125jdavis/gauge/(threads)

Thread 11 (2025-06-10):

Add configuration file to improve code maintainability

125jdavis, 2025-06-10:
This change proposes adding a dedicated configuration file to improve code maintainability and make the gauge system more configurable.

## Proposed Configuration File

```cpp name=config.h
#ifndef GAUGE_CONFIG_H
#define GAUGE_CONFIG_H

// Pin Configurations
namespace PinConfig {
    // Analog Input Pins
    constexpr int VBATT_PIN = A0;       // Battery voltage sensing
    constexpr int FUEL_PIN = A1;        // Fuel level sensing
    constexpr int THERM_PIN = A2;       // Temperature sensor
    constexpr int BARO_PIN = A3;        // Barometric pressure sensor

    // Digital Output Pins
    constexpr int PWR_PIN = 2;          // Power control
    constexpr int MOTOR_RST = 3;        // Stepper motor reset
    constexpr int TACH_DATA_PIN = 4;    // LED tachometer data

    // Odometer Pins
    constexpr int ODO_PIN1 = 5;
    constexpr int ODO_PIN2 = 6;
    constexpr int ODO_PIN3 = 7;
    constexpr int ODO_PIN4 = 8;

    // CAN Bus Pins
    constexpr int CAN0_INT = 9;         // CAN interrupt pin
}

// Timing Constants (all in milliseconds)
namespace TimingConfig {
    constexpr unsigned long SPLASH_TIME = 3000;        // Splash screen duration
    constexpr unsigned long SENSOR_READ_RATE = 100;    // Sensor reading interval
    constexpr unsigned long CAN_SEND_RATE = 50;        // CAN message transmission interval
    constexpr unsigned long DISPLAY_UPDATE_RATE = 50;  // Display refresh rate
    constexpr unsigned long GPS_UPDATE_RATE = 200;     // GPS data fetch interval
    constexpr unsigned long TACH_UPDATE_RATE = 50;     // Tachometer update interval
    constexpr unsigned long ANGLE_UPDATE_RATE = 20;    // Gauge pointer update interval
    constexpr unsigned long DEBOUNCE_DELAY = 50;       // Switch debounce delay
}

// Display Configuration
namespace DisplayConfig {
    constexpr int SCREEN_W = 128;       // Display width in pixels
    constexpr int SCREEN_H = 32;        // Display height in pixels
    constexpr bool ROTATION = false;     // Display rotation (false = normal, true = 180°)
}

// Gauge Ranges and Limits
namespace GaugeConfig {
    // Tachometer
    constexpr int TACH_MIN = 0;         // Minimum RPM
    constexpr int TACH_MAX = 7000;      // Maximum RPM
    constexpr int NUM_LEDS = 16;        // Number of LEDs in tachometer
    constexpr int WARN_LEDS = 2;        // Number of warning LEDs
    constexpr int SHIFT_LEDS = 1;       // Number of shift indicator LEDs

    // Speedometer
    constexpr int SPEEDO_MAX = 12000;   // Maximum speed (x100 for precision)

    // Stepper Motor Configuration
    constexpr int M1_SWEEP = 120;       // Sweep angle for motor 1
    constexpr int M2_SWEEP = 120;       // Sweep angle for motor 2
    constexpr int M3_SWEEP = 240;       // Sweep angle for motor 3
    constexpr int M4_SWEEP = 120;       // Sweep angle for motor 4
}

// Sensor Filtering and Scaling
namespace SensorConfig {
    // Filter coefficients (0-64)
    constexpr int FILTER_VBATT = 32;    // Battery voltage filter strength
    constexpr int FILTER_FUEL = 32;     // Fuel level filter strength
    constexpr int FILTER_THERM = 32;    // Temperature filter strength
    constexpr int FILTER_BARO = 32;     // Barometric pressure filter strength

    // Scaling factors
    constexpr float VBATT_SCALER = 0.0208;  // Battery voltage scaling factor
    constexpr float FUEL_CAPACITY = 16.0;    // Fuel tank capacity in gallons
}

// CAN Bus Configuration
namespace CANConfig {
    constexpr long CAN_SPEED = CAN_500KBPS;
    constexpr int CAN_CS = 10;          // CS pin for CAN controller

    // CAN Message IDs
    constexpr uint32_t ID_ENGINE_DATA = 0x360;    // Engine data message ID
    constexpr uint32_t ID_SENSOR_DATA = 0x361;    // Sensor data message ID
    constexpr uint32_t ID_STATUS = 0x362;         // Status message ID
}

// EEPROM Storage Addresses
namespace StorageConfig {
    constexpr int DISP_ARRAY1_ADDR = 0;          // Display 1 configuration
    constexpr int DISP_ARRAY2_ADDR = 10;         // Display 2 configuration
    constexpr int CLOCK_OFFSET_ADDR = 20;        // Clock offset
    constexpr int ODO_ADDR = 30;                 // Odometer value
    constexpr int ODO_TRIP_ADDR = 40;            // Trip odometer value
    constexpr int FUEL_SENSOR_RAW_ADDR = 50;     // Raw fuel sensor value
    constexpr int UNITS_ADDR = 60;               // Units configuration (metric/imperial)
}

#endif // GAUGE_CONFIG_H
```

## Implementation Steps

1. Create the new `config.h` file in the project.
2. Update the main sketch to include and use the configuration file:
   ```cpp
   #include "config.h"
   ```
3. Replace all hardcoded values in the main sketch with references to the configuration constants.
4. Update any affected functions to use the new configuration values.

## Benefits

1. **Improved Maintainability**
   - All configuration values are in one place
   - Easy to find and modify settings
   - Better documentation of what each value represents

2. **Better Organization**
   - Related settings are grouped together
   - Clear separation of different types of configuration
   - Namespaces prevent naming conflicts

3. **Easier Customization**
   - Simple to modify values for different vehicle applications
   - Clear documentation of valid ranges and units
   - Configuration can be changed without modifying main code

4. **Reduced Risk of Errors**
   - Use of constexpr ensures compile-time checking
   - Prevents accidental modification of constants
   - Consistent naming conventions

## Testing Plan

1. Compare all values in the configuration file against current implementation
2. Test the system with the new configuration values
3. Verify that all functionality remains the same
4. Test boundary conditions with different configuration values

## Future Considerations

- Consider adding configuration validation functions
- Could expand to include different preset configurations for different vehicles
- Might want to add debug configuration options
