125jdavis/gauge/documentation/Schematic_gauge-module-v4_2025-11-08.pdf

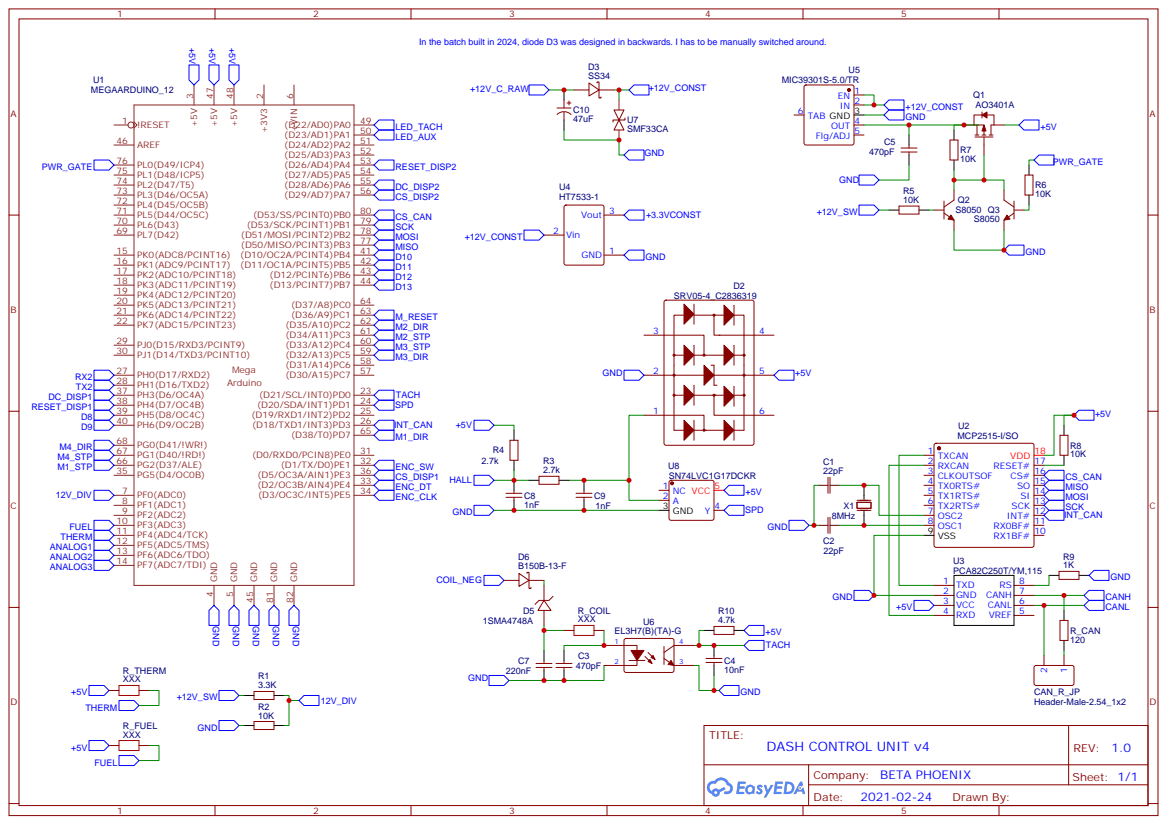
[picture p1: page 1]

In the batch built in 2024, diode D3 was designed in backwards. I has to be manually switched around.

11 11 12 12 13 13 14 14 15 15 16 16

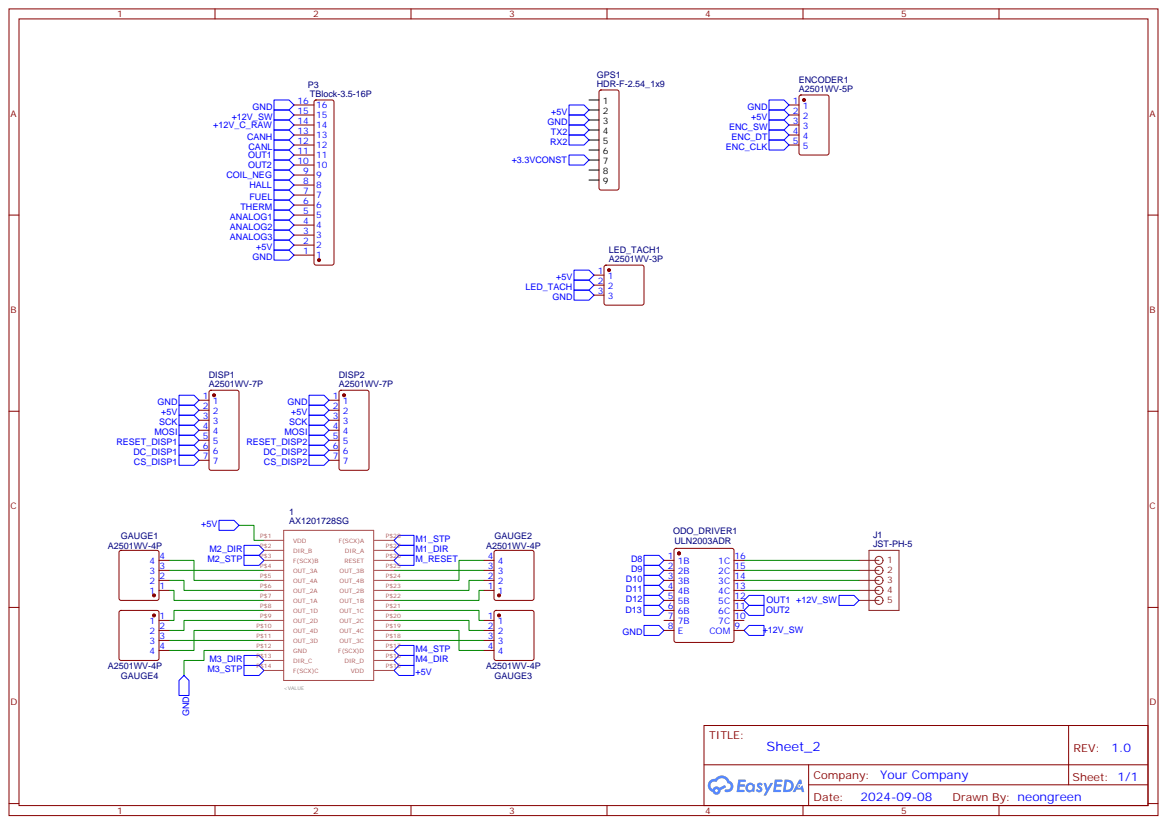
[picture p2: page 2]
