125jdavis/gauge/gauge_V4/gauge_V4.ino

/*
 * ========================================
 * GAUGE CONTROL MODULE
 * ========================================
 * 
 * Arduino-based instrument panel controller for vintage vehicles
 * 
 * Author: Jesse Davis
 * Date: 8/24/2024
 * 
 * OVERVIEW:
 * This system receives inputs from GPS, analog sensors, and CAN bus, then outputs to:
 * - 4x stepper motors for gauge pointers (speedometer, fuel, coolant temp, etc.)
 * - LED warning lights and LED tachometer strip
 * - 2x OLED displays for various vehicle data
 * - CAN bus messages to other microcontrollers
 * 
 * The design is modular to simplify retrofitting vintage instrument panels with modern internals.
 * 
 * HARDWARE:
 * - Arduino Mega 2560 (or compatible)
 * - MCP2515 CAN bus controller
 * - Adafruit GPS module
 * - 2x SSD1306 OLED displays (128x32 pixels)
 * - 4x SwitecX12 stepper motors for gauge needles
 * - WS2812 LED strip for tachometer
 * - Rotary encoder for menu navigation
 * - Various analog sensors (fuel level, thermistor, barometric pressure, battery voltage)
 * 
 * COMMUNICATION PROTOCOLS:
 * - CAN bus at 500kbps (Haltech ECU protocol)
 * - GPS at 9600 baud, NMEA RMC messages at 5Hz
 * - SPI for displays and CAN controller
 * 
 * ========================================
 */

///// LIBRARIES /////
// Display libraries
#include <Adafruit_SSD1306.h>
#include <Adafruit_GFX.h>

// Communication libraries
#include <SPI.h>
#include <mcp_can.h>

// Input libraries
#include <Rotary.h>

// Storage library
#include <EEPROM.h>

// LED library
#include <FastLED.h>

// GPS library
#include <Adafruit_GPS.h>

// Stepper motor libraries
#include <SwitecX25.h>
#include <SwitecX12.h>

///// PROJECT MODULES /////
#include "config_hardware.h"
#include "config_calibration.h"
#include "globals.h"
#include "gps.h"
#include "can.h"
#include "sensors.h"
#include "display.h"
#include "outputs.h"
#include "menu.h"
#include "utilities.h"
#include "image_data.h"
#include "serial_config.h"
#include "splash.h"



/*
 * ========================================
 * TIMER-BASED MOTOR UPDATE ISR
 * ========================================
 * 
 * This ISR is called at MOTOR_UPDATE_FREQ_HZ (default 10 kHz) by Timer3
 * to provide deterministic, smooth motor stepping independent of main loop timing.
 * 
 * Design rationale:
 * - Main loop has variable execution time due to display updates, CAN, GPS parsing
 * - update() calls from main loop result in irregular step timing → jerky motion
 * - Timer-driven updates provide consistent intervals → smooth motion
 * - 10 kHz frequency ensures steps at max motor speed don't accumulate delays
 * 
 * ISR performance:
 * - Executes in ~10-20 µs with 5 motors (measured on Mega 2560)
 * - At 10 kHz: ~10-20% CPU overhead (10-20 µs per 100 µs period)
 * - Kept minimal: only calls update() on each motor, no complex logic
 * 
 * Motors updated:
 * - motor1, motor2, motor3, motor4 (SwitecX12 gauge motors)
 * - motorS (SwitecX12 speedometer motor)
 * - updateOdometerMotor() (mechanical odometer, custom non-blocking implementation)
 */
ISR(TIMER3_COMPA_vect) {
  // Update all gauge motors (SwitecX12)
  // These motors have internal acceleration/deceleration logic
  // and track their own timing via micros()
  motor1.update();
  motor2.update();
  motor3.update();
  motor4.update();
  motorS.update();
  
  // Update mechanical odometer motor (custom non-blocking implementation)
  updateOdometerMotor();
}

/**
 * initMotorUpdateTimer - Initialize Timer3 for motor update ISR
 * 
 * Configures Timer3 to generate periodic interrupts at MOTOR_UPDATE_FREQ_HZ
 * for deterministic motor stepping.
 * 
 * Timer3 configuration:
 * - Mode: CTC (Clear Timer on Compare Match) - resets counter at OCR3A
 * - Prescaler: 8 (provides good resolution for target frequency range)
 * - Compare value: Calculated from F_CPU and target frequency
 * 
 * Calculation:
 * - Timer frequency = F_CPU / prescaler = 16 MHz / 8 = 2 MHz
 * - Timer ticks per interrupt = timer_freq / target_freq
 * - For 10 kHz target: 2,000,000 / 10,000 = 200 ticks
 * - OCR3A = 200 - 1 = 199 (compare triggers at 199, giving 200 ticks per cycle)
 * 
 * CPU overhead:
 * - ISR executes ~10-20 µs
 * - At 10 kHz: 100-200 µs per millisecond = 10-20% worst case
 * - Typical is lower due to early exits in update()
 */
void initMotorUpdateTimer() {
  // Disable interrupts while configuring timer
  cli();
  
  // Timer3 configuration for CTC mode
  TCCR3A = 0;  // Clear control register A
  TCCR3B = 0;  // Clear control register B
  TCNT3 = 0;   // Initialize counter to 0
  
  // Calculate compare match value
  // Formula: OCR3A = (F_CPU / (prescaler * target_frequency)) - 1
  // With prescaler = 8:
  //   Timer frequency = 16 MHz / 8 = 2 MHz
  //   For 10 kHz: OCR3A = (2,000,000 / 10,000) - 1 = 199
  const uint16_t prescaler = 8;
  const uint32_t timer_freq = F_CPU / prescaler;  // 2 MHz with prescaler=8
  const uint16_t compare_value = (timer_freq / MOTOR_UPDATE_FREQ_HZ) - 1;
  
  OCR3A = compare_value;  // Set compare match register
  
  // Configure Timer3 for CTC mode with prescaler = 8
  // CTC mode: WGM32:0 = 0b0100 (CTC mode, TOP = OCR3A)
  // CS32:0 = 0b010 (prescaler = 8)
  TCCR3B |= (1 << WGM32) | (1 << CS31);
  
  // Enable Timer3 Compare A interrupt
  TIMSK3 |= (1 << OCIE3A);
  
  // Re-enable interrupts
  sei();
  
  // Debug output
  Serial.print(F("Motor update timer initialized: "));
  Serial.print(MOTOR_UPDATE_FREQ_HZ);
  Serial.print(F(" Hz (OCR3A="));
  Serial.print(compare_value);
  Serial.println(F(")"));
}

/*
 * ========================================
 * SETUP FUNCTION
 * ========================================
 */
void setup() {

  // Initialize serial communication for debugging
  Serial.begin(115200);

  // Keep power enabled after ignition switch turns off
  pinMode(PWR_PIN, OUTPUT);
  digitalWrite(PWR_PIN, HIGH);

  // ===== GPS INITIALIZATION =====
  GPS.begin(9600);
  GPS.sendCommand(PMTK_SET_NMEA_OUTPUT_RMCONLY);
  GPS.sendCommand(PMTK_SET_NMEA_UPDATE_5HZ);
  GPS.sendCommand(PMTK_API_SET_FIX_CTL_5HZ);
  useInterrupt(true);
 
  // ===== HALL SENSOR INITIALIZATION =====
  pinMode(HALL_PIN, INPUT_PULLUP);
  attachInterrupt(digitalPinToInterrupt(HALL_PIN), hallSpeedISR, FALLING);

  // ===== ENGINE RPM SENSOR INITIALIZATION =====
  pinMode(IGNITION_PULSE_PIN, INPUT_PULLUP);
  attachInterrupt(digitalPinToInterrupt(IGNITION_PULSE_PIN), ignitionPulseISR, FALLING);

  // ===== DISPLAY INITIALIZATION =====
  // Initialize displays (SPI clock speed set by library default)
  // begin(vccstate, i2caddr, reset, periphBegin)
  display1.begin(SSD1306_SWITCHCAPVCC, 0, true, true);
  display2.begin(SSD1306_SWITCHCAPVCC, 0, true, true);
  dispFalconScript(&display1);
  disp302CID(&display2);
  
  // ===== STEPPER MOTOR INITIALIZATION =====
  pinMode(MOTOR_RST, OUTPUT);
  digitalWrite(MOTOR_RST, HIGH);
  motorSweepSynchronous();
  
  // ===== ODOMETER MOTOR SETUP =====
  pinMode(ODO_PIN1, OUTPUT);
  pinMode(ODO_PIN2, OUTPUT);
  pinMode(ODO_PIN3, OUTPUT);
  pinMode(ODO_PIN4, OUTPUT);

  // ===== LED TACHOMETER INITIALIZATION =====
  if (!loadTachSettings()) {
    Serial.println(F("Warning: invalid tach settings in EEPROM; using defaults"));
  }
  if (NUM_LEDS > MAX_LEDS) {
    NUM_LEDS = MAX_LEDS;
    Serial.println("Warning: NUM_LEDS exceeds MAX_LEDS, clamped to maximum");
  }
  FastLED.addLeds<WS2812, TACH_DATA_PIN, GRB>(leds, NUM_LEDS);

  // ===== ROTARY ENCODER SETUP =====
  pinMode(SWITCH, INPUT_PULLUP);
  attachInterrupt(digitalPinToInterrupt(2), rotate, CHANGE);
  attachInterrupt(digitalPinToInterrupt(3), rotate, CHANGE);
  
  // ===== LOAD SAVED SETTINGS FROM EEPROM =====
  for (int i = 0; i < sizeof(dispArray1); i++) {
    dispArray1[i] = EEPROM.read(dispArray1Address + i);
  }
  dispArray2[0] = EEPROM.read(dispArray2Address);
  loadScreenLists();  // Also forces the restored screens to be members of their lists
  clockOffset = EEPROM.read(clockOffsetAddress); 
  EEPROM.get(odoAddress, odo);
  EEPROM.get(odoTripAddress, odoTrip);
  EEPROM.get(fuelSensorRawAddress, fuelSensorRaw);
  EEPROM.get(unitsAddress, units);

  Serial.print("clockOffset: ");
  Serial.println(clockOffset);
  
  // ===== CAN BUS INITIALIZATION =====
  if(CAN0.begin(MCP_ANY, CAN_500KBPS, MCP_8MHZ) == CAN_OK) 
    Serial.println("MCP2515 Initialized Successfully!");
  else 
    Serial.println("Error Initializing MCP2515...");
  
  // Configure hardware filters to reduce MCU load
  configureCANFilters();
  Serial.print("CAN filters configured for protocol: ");
  Serial.println(CAN_PROTOCOL);
  
  pinMode(CAN0_INT, INPUT);
  CAN0.setMode(MCP_NORMAL);

  // ===== MOTOR UPDATE TIMER INITIALIZATION =====
  // Initialize Timer3 for deterministic motor stepping at MOTOR_UPDATE_FREQ_HZ
  // This must be done after motor initialization but before main loop starts
  initMotorUpdateTimer();

  // ===== SPLASH SCREEN DELAY =====
  while (millis() < SPLASH_TIME){
    // Wait for splash screen timer to expire
  }

}

/*
 * ========================================
 * MAIN LOOP FUNCTION
 * ========================================
 */
void loop() {

  // ===== ANALOG SENSOR READING =====
  if (millis() - timerSensorRead > SENSOR_READ_RATE) {
    static int32_t battFilterState = 0;
    static int32_t fuelFilterState = 0;
    vBattRaw = readSensor(VBATT_PIN, vBattRaw, FILTER_VBATT, battFilterState);
    vBatt = (float)vBattRaw * VBATT_SCALER;
    
    fuelSensorRaw = readSensor(FUEL_PIN, fuelSensorRaw, FILTER_FUEL, fuelFilterState);
    
    thermSensor = readThermSensor(THERM_PIN, thermSensor, FILTER_THERM);
    therm = curveLookup((uint16_t)(thermSensor * 1000.0f), thermTable_x, thermTable_l, thermTable_length);
    thermCAN = (int)(therm*10);
    
    sensor_av1 = readMappedSensor(PIN_AV1, sensor_av1, FILTER_AV1, 0, AV1_TYPE);
    sensor_av2 = readMappedSensor(PIN_AV2, sensor_av2, FILTER_AV2, 1, AV2_TYPE);
    sensor_av3 = readMappedSensor(PIN_AV3, sensor_av3, FILTER_AV3, 2, AV3_TYPE);

        swRead();
    
    timerSensorRead = millis();
  }

  // ===== HALL SENSOR READING ======
  if (millis() - timerHallUpdate > HALL_UPDATE_RATE) {
    hallSpeedUpdate();
    timerHallUpdate = millis();
  }

  // ===== ENGINE RPM SENSOR READING =====
  if (millis() - timerEngineRPMUpdate > ENGINE_RPM_UPDATE_RATE) {
    engineRPMUpdate();
    timerEngineRPMUpdate = millis();
  }

  // ===== CAN BUS RECEPTION =====
  // Drain all pending frames: the MCP2515 only has 2 RX buffers, so reading one frame
  // per loop pass drops frames (e.g. 0x370 speed) when the loop is slow
  for (byte canReads = 0; canReads < 16 && !digitalRead(CAN0_INT); canReads++) {
    receiveCAN();
    parseCAN(rxId, 0);
  }

  // ===== OBDII POLLING =====
  // Poll ECU for parameters when using OBDII protocol
  if (CAN_PROTOCOL == CAN_PROTOCOL_OBDII) {
    pollOBDII();
  }

  // ===== GPS DATA PROCESSING =====
  if (millis() - timerCheckGPS > CHECK_GPS_RATE) {
    fetchGPSdata();
    timerCheckGPS = millis();
  }

  // ===== SERIAL COMMAND PROCESSING =====
  // Parse serial input for manual signal injection (spd, rpm, odo motor commands)
  processSerialCommands();

  // ===== SIGNAL SELECTION UPDATE =====
  // Process sensor readings and synthetic signal generators
  // Runs at 100Hz for responsive synthetic signals
  if (millis() - timerSigSelectUpdate > SIG_SELECT_UPDATE_RATE) {
    sigSelect();
    timerSigSelectUpdate = millis();
  }

  // ===== MOTOR ANGLE UPDATE =====
  // Set target positions for motors based on sensor readings
  // The actual stepping is handled by Timer3 ISR at MOTOR_UPDATE_FREQ_HZ
  // This decouples position updates (slow, ~50 Hz) from stepping (fast, 10 kHz)
  // CRITICAL: This block is positioned BEFORE display updates to ensure consistent timing.
  // Display updates are blocking operations (~10-20ms) that would otherwise delay
  // angle updates, causing visible jitter/ticks in motor motion.
  if (millis() - timerAngleUpdate > ANGLE_UPDATE_RATE) {
    //Serial.println(millis() - timerAngleUpdate);
    // Motors 1-4 use smoothing: update targets at ANGLE_UPDATE_RATE, interpolation happens below
    updateMotors1to4Target(motorFunctionAngle(M1_FUNCTION, M1_SWEEP, M1_MIN, M1_MAX),
                           motorFunctionAngle(M2_FUNCTION, M2_SWEEP, M2_MIN, M2_MAX),
                           motorFunctionAngle(M3_FUNCTION, M3_SWEEP, M3_MIN, M3_MAX),
                           motorFunctionAngle(M4_FUNCTION, M4_SWEEP, M4_MIN, M4_MAX));
    // Motor S uses smoothing: update target at ANGLE_UPDATE_RATE, interpolation happens below
    updateMotorSTarget(MS_SWEEP);
    timerAngleUpdate = millis();
  }
  
  // ===== MOTOR S POSITION SMOOTHING =====
  // Continuously interpolate motorS position between target updates for smooth motion
  // Called every loop iteration (typically >1kHz) to provide frequent position updates
  // that the Timer3 ISR can act upon. This creates smooth needle motion instead of
  // the jerky "move-stop-wait" behavior that occurs without interpolation.
  updateMotorSSmoothing();

  // ===== MOTORS 1-4 POSITION SMOOTHING =====
  // Same adaptive linear interpolation as motorS, applied to the fuel/temp gauge motors.
  updateMotors1to4Smoothing();

  // ===== MOTOR STEP EXECUTION =====
  // Motor updates (stepping) are now handled by Timer3 ISR for deterministic timing
  // The ISR calls:
  //   - motor1/2/3/4/S.update() for gauge motors
  //   - updateOdometerMotor() for mechanical odometer
  // 
  // This provides smooth motion independent of main loop timing variations
  // caused by display updates, GPS parsing, CAN processing, etc.
  //
  // Note: Do not call update() here - would conflict with ISR and cause race conditions

  // ===== LED TACHOMETER UPDATE =====
  if (millis() - timerTachUpdate > TACH_UPDATE_RATE) {
    ledShiftLight(RPM);
    timerTachUpdate = millis();
  }

  // ===== DISPLAY UPDATE =====
  // Positioned AFTER motor angle updates to prevent blocking OLED operations
  // from delaying time-critical motor position updates
  // Each display uses independent timing with variable refresh rates based on content
  
  // Check for user input requiring immediate display update
  bool needsImmediateUpdate = (button == 1) || encoderMoved;
  
  // Display 1 update - Variable refresh rate based on content type
  // Update immediately on user input, or at scheduled interval
  unsigned int disp1Interval = getDisplayUpdateInterval(dispArray1[0], 1);
  if (needsImmediateUpdate || (millis() - timerDisp1Update > disp1Interval)) {
    // Force a full redraw when the user scrolled to a new screen, so the display
    // function always sees modeChanged=true and clears leftover content.
    if (encoderMoved) {
      dispArray1_prev[0] = 255;
    }
    dispMenu();
    timerDisp1Update = millis();
    encoderMoved = false;  // Clear flag after update
  }
  
  // Display 2 update - Variable refresh rate based on content type
  // Update immediately when selection changes (e.g., scrolling through Display 2 options in Settings)
  // or when button is pressed (entering Display 2 submenu), or at scheduled interval for data refresh
  bool disp2SelectionChanged = (dispArray2[0] != dispArray2_prev);
  bool needsDisp2Update = disp2SelectionChanged || needsImmediateUpdate;
  unsigned int disp2Interval = getDisplayUpdateInterval(dispArray2[0], 2);
  if (needsDisp2Update || (millis() - timerDisp2Update > disp2Interval)) {
    // Force a full redraw when the Display 2 selection changed, so the display
    // function always sees modeChanged=true and clears leftover content.
    if (disp2SelectionChanged) {
      dispArray2_prev = 255;
    }
    disp2();
    timerDisp2Update = millis();
  }

  // ===== FAULT DEBOUNCE + FLASH =====
  // Raw fault conditions are debounced: each must persist continuously for
  // FAULT_DEBOUNCE_MS before the warning (OLED invert + LED) activates.
  // Clearing the condition immediately resets the debounce timer.
  //
  // Fault conditions:
  //   - Oil pressure below OIL_PRS_WARN_THRESHOLD (kPa gauge) while engine is running
  //   - Coolant temperature above COOLANT_TEMP_WARN_THRESHOLD (°C) while engine is running
  //   - Battery voltage below BATT_VOLT_WARN_THRESHOLD (V) (engine-state independent)
  //   - Fuel level below FUEL_LVL_WARN_THRESHOLD_PCT (%) when fuel source is active
  {
    bool engineRunning = (RPM >= ENGINE_RUNNING_RPM_MIN);
    bool oilPrsRaw  = engineRunning && (oilPrs < OIL_PRS_WARN_THRESHOLD);
    bool coolantRaw = engineRunning && (coolantTemp > COOLANT_TEMP_WARN_THRESHOLD);
    bool battRaw    = (vBatt > BATT_VOLT_MIN_VALID) && (vBatt < BATT_VOLT_WARN_THRESHOLD);
    bool fuelRaw    = (FUEL_LVL_SOURCE != 0) && (fuelLvlCAN < FUEL_LVL_WARN_THRESHOLD_PCT);

    // Debounce: reset timer while condition is false; activate after FAULT_DEBOUNCE_MS
    unsigned long now = millis();
    if (!oilPrsRaw)  { timerOilFaultDebounce     = now; oilFaultActive     = false; }
    else if (now - timerOilFaultDebounce     >= FAULT_DEBOUNCE_MS) oilFaultActive     = true;
    if (!coolantRaw) { timerCoolantFaultDebounce  = now; coolantFaultActive = false; }
    else if (now - timerCoolantFaultDebounce >= FAULT_DEBOUNCE_MS) coolantFaultActive = true;
    if (!battRaw)    { timerBattFaultDebounce     = now; battFaultActive    = false; }
    else if (now - timerBattFaultDebounce    >= FAULT_DEBOUNCE_MS) battFaultActive    = true;
    if (!fuelRaw)    { timerFuelFaultDebounce     = now; fuelFaultActive    = false; }
    else if (now - timerFuelFaultDebounce    >= FAULT_DEBOUNCE_MS) fuelFaultActive    = true;

    // Determine which displays are showing a faulted reading
    bool disp1Fault = (oilFaultActive     && (dispArray1[0] == 1)) ||
                      (coolantFaultActive && (dispArray1[0] == 2)) ||
                      (fuelFaultActive    && (dispArray1[0] == 3)) ||
                      (battFaultActive    && (dispArray1[0] == 4));
    bool disp2Fault = (oilFaultActive     && (dispArray2[0] == 1)) ||
                      (coolantFaultActive && (dispArray2[0] == 2)) ||
                      (fuelFaultActive    && (dispArray2[0] == 3)) ||
                      (battFaultActive    && (dispArray2[0] == 4));

    // Toggle flash state every FAULT_FLASH_INTERVAL_MS
    if (millis() - timerFaultFlash >= FAULT_FLASH_INTERVAL_MS) {
      faultFlashState = !faultFlashState;
      timerFaultFlash = millis();
    }

    // Apply hardware inversion only when the desired state changes, to minimize SPI traffic
    static bool disp1InvertPrev = false;
    static bool disp2InvertPrev = false;
    bool disp1Invert = disp1Fault && faultFlashState;
    bool disp2Invert = disp2Fault && faultFlashState;
    if (disp1Invert != disp1InvertPrev) {
      display1.invertDisplay(disp1Invert);
      disp1InvertPrev = disp1Invert;
    }
    if (disp2Invert != disp2InvertPrev) {
      display2.invertDisplay(disp2Invert);
      disp2InvertPrev = disp2Invert;
    }
  }

  // ===== CAN BUS TRANSMISSION =====
  if (millis() - timerCANsend > CAN_SEND_RATE) {  
    //sendCAN_BE(0x200, 0, spdCAN, 0, 0);
    timerCANsend = millis();
  }


  //===== SHUTDOWN DETECTION =====
  //Check if ignition voltage has dropped (key turned off)
  //Shutdown when battery voltage < 1V AND system has been running for at least 3 seconds
  if (vBatt < 1 && millis() > SPLASH_TIME + 3000) {
    shutdown();  // Save settings, zero gauges, display shutdown screen, cut power
  }


}
