125jdavis/gauge/gauge_V4/sensors.cpp

/*
 * ========================================
 * SENSOR READING FUNCTIONS IMPLEMENTATION
 * ========================================
 */

#include "sensors.h"
#include "globals.h"
#include "outputs.h"
#include "utilities.h"
#include "ema_filter.h"
#include <util/atomic.h>

static volatile int32_t rpmFilterState = 0;

// ===== VR-SAFE COMBINED FILTER STATE =====
// State machine for startup filtering (VR-safe, Hall-compatible)
enum SpeedSensorState {
    STANDSTILL,  // No recent pulses, speed = 0
    STARTING,    // Pulses arriving but not yet coherent
    MOVING       // Normal operation, speed output active
};

// Ring buffer for median filter on pulse intervals
#define INTERVAL_BUFFER_SIZE 5
static unsigned long intervalBuffer[INTERVAL_BUFFER_SIZE] = {0};
static uint8_t intervalBufferIndex = 0;
static uint8_t intervalBufferCount = 0;

// State machine variables
static SpeedSensorState sensorState = STANDSTILL;
static unsigned long lastFilteredInterval = 0;
static unsigned long lastPulseArrivalTime = 0;  // Track when last pulse was added to buffer

// Previous speed for acceleration limiting
static unsigned int spdHallPrev = 0;
static unsigned long lastSpeedUpdateTime = 0;

// CAN odometer update tracking
static unsigned long lastCANOdometerUpdateTime = 0;

// Synthetic speed odometer update tracking
static unsigned long lastSyntheticOdometerUpdateTime = 0;

// Serial speed odometer update tracking
static unsigned long lastSerialOdometerUpdateTime = 0;

// VR-Safe filter constants
#define LOW_SPEED_THRESHOLD_FOR_VR_REJECTION 1000  // 10 km/h in units of km/h*100
#define MAX_ACCELERATION_UNITS 3530UL  // 1g acceleration ≈ 35.3 km/h/s ≈ 3530 (km/h*100)/s

static unsigned long filterIntegerSensor(unsigned long newVal, int oldVal, int filt, int32_t &state)
{
    if (state / 128 != oldVal) state = (int32_t)oldVal * 128;
    state = ema7Step((int32_t)newVal * 128, state, filt);
    return state / 128;
}

/**
 * readSensor - Generic analog sensor reader with filtering
 */
unsigned long readSensor(int inputPin, int oldVal, int filt, int32_t &state)
{
    int raw = analogRead (inputPin);  // Read ADC: 0-1023 for 0-5V input
    unsigned long newVal = map( raw, 0, 1023, 0, 500);  // Map to 0-500 (0.00-5.00V in 0.01V steps)
    return filterIntegerSensor(newVal, oldVal, filt, state);
}

/**
 * read30PSIAsensor - Read 30 PSI absolute pressure sensor
 */
unsigned long read30PSIAsensor(int inputPin, int oldVal, int filt, int32_t &state)
{
    int raw = constrain(analogRead(inputPin), 102, 921);  // Read ADC: 0-1023
    unsigned long newVal = map( raw, 102, 921, 0, 2068);  // Map 0.5-4.5V to 0-30 PSIA (0-206.8 kPa)
    return filterIntegerSensor(newVal, oldVal, filt, state);
}

/**
 * read3barMapSensor - Read a 3 bar absolute MAP sensor
 */
unsigned long read3barMapSensor(int inputPin, int oldVal, int filt, int32_t &state)
{
    int raw = constrain(analogRead(inputPin), 102, 921);
    unsigned long newVal = map(raw, 102, 921, 0, 3000);
    return filterIntegerSensor(newVal, oldVal, filt, state);
}

/**
 * read100PSIGsensor - Read a 0-100 PSIG pressure sensor
 */
unsigned long read100PSIGsensor(int inputPin, int oldVal, int filt, int32_t &state)
{
    int raw = constrain(analogRead(inputPin), 102, 921);
    unsigned long newVal = map(raw, 102, 921, 0, 6895);
    return filterIntegerSensor(newVal, oldVal, filt, state);
}

/**
 * readMappedSensor - Linearly map an AV input using its ADC/physical calibration points
 *
 * Result is in the calibration's physical units (absolute kPa*10 or Lambda*1000).
 * AV_TYPE_NONE inputs return raw voltage (0.01V units).
 */
float readMappedSensor(int inputPin, float oldVal, int filt, uint8_t avIndex, uint8_t type)
{
    if (type == AV_TYPE_NONE) {
        long newVal = map(analogRead(inputPin), 0, 1023, 0, 500);
        return ema7Step(newVal * 128, (int32_t)(oldVal * 128), filt) / 128.0f;
    }
    long adcLo = AV_ADC_LO[avIndex];
    long adcHi = AV_ADC_HI[avIndex];
    if (adcLo == adcHi) return AV_PHYS_LO[avIndex];
    long raw = constrain((long)analogRead(inputPin), min(adcLo, adcHi), max(adcLo, adcHi));
    long newVal = map(raw, adcLo, adcHi, AV_PHYS_LO[avIndex], AV_PHYS_HI[avIndex]);
    return ema7Step(newVal * 128, (int32_t)(oldVal * 128), filt) / 128.0f;
}

/**
 * avGaugeKpa / avAbsoluteKpa - Convert an AV reading (absolute kPa*10) to kPa gauge / absolute
 */
static float avGaugeKpa(float raw)
{
    return raw / 10.0 - 101.3;
}

static float avAbsoluteKpa(float raw)
{
    return raw / 10.0;
}
/**
 * readThermSensor - Read GM-style thermistor temperature sensor
 */
float readThermSensor(int inputPin, float oldVal, int filt)
{
    int raw = analogRead (inputPin);  // Read ADC: 0-1023
    int32_t newMillivolts = map(raw, 0, 1023, 0, 500) * 10L;
    int32_t state = (int32_t)(oldVal * 128000.0f + 0.5f);
    return ema7Step(newMillivolts * 128, state, filt) / 128000.0f;
}

/**
 * getMedianInterval - Calculate median of interval buffer
 * VR-Safe: Median filter rejects outlier pulses from VR sensor noise
 * Hall-Compatible: Works identically with clean Hall sensor pulses
 * 
 * @return Median interval from buffer, or 0 if buffer empty
 */
static unsigned long getMedianInterval() {
    if (intervalBufferCount == 0) return 0;
    
    // Create a copy for sorting (small N, simple bubble sort is fine)
    unsigned long sorted[INTERVAL_BUFFER_SIZE];
    uint8_t n = intervalBufferCount;
    
    for (uint8_t i = 0; i < n; i++) {
        sorted[i] = intervalBuffer[i];
    }
    
    // Bubble sort (safe against underflow)
    for (uint8_t i = 0; i < n - 1 && i < n; i++) {
        for (uint8_t j = 0; j + i + 1 < n; j++) {
            if (sorted[j] > sorted[j + 1]) {
                unsigned long temp = sorted[j];
                sorted[j] = sorted[j + 1];
                sorted[j + 1] = temp;
            }
        }
    }
    
    // Return median
    if (n % 2 == 1) {
        return sorted[n / 2];
    } else {
        return (sorted[n / 2 - 1] + sorted[n / 2]) / 2;
    }
}

/**
 * checkIntervalCoherence - Check if intervals in buffer are coherent
 * VR-Safe: Ensures startup intervals are stable before outputting speed
 * 
 * @return true if max/min ratio < 1.5, false otherwise
 */
static bool checkIntervalCoherence() {
    if (intervalBufferCount < INTERVAL_BUFFER_SIZE) return false;
    
    unsigned long minInterval = intervalBuffer[0];
    unsigned long maxInterval = intervalBuffer[0];
    
    for (uint8_t i = 1; i < intervalBufferCount; i++) {
        if (intervalBuffer[i] < minInterval) minInterval = intervalBuffer[i];
        if (intervalBuffer[i] > maxInterval) maxInterval = intervalBuffer[i];
    }
    
    // Avoid division by zero
    if (minInterval == 0) return false;
    
    // Check if max/min < 1.5 (coherence threshold)
    // Use integer math: maxInterval < 1.5 * minInterval
    // Equivalent to: maxInterval * 2 < minInterval * 3
    return (maxInterval * 2) < (minInterval * 3);
}

/**
 * hallSpeedISR - Hall effect speed sensor interrupt handler
 * 
 * ISR Design: Lightweight and deterministic
 * - Captures pulse timestamp using micros()
 * - Performs basic sanity checks on pulse interval
 * - Enqueues interval into ring buffer for median filtering
 * - All heavy processing deferred to hallSpeedUpdate() in main loop
 * 
 * Performance: ~8-15 µs execution time (mostly conditional checks)
 * 
 * VR-Safe Combined Filter Implementation:
 * - Timestamps pulses and enqueues intervals into ring buffer
 * - Rejects intervals that fail basic sanity checks
 * - VR-Safe: Rejects edge misfires at low speed (interval < 0.4× previous)
 * - Hall-Compatible: All checks pass transparently for clean Hall signals
 * 
 * Heavy processing deferred to main loop:
 * - Median filtering
 * - State machine transitions
 * - Speed calculation
 * - Acceleration limiting
 */
void hallSpeedISR() {
    unsigned long currentTime = micros();
    unsigned long pulseInterval = currentTime - hallLastTime;
    
    // Basic interval sanity checks
    // Minimum: 100 μs (filters electrical noise, allows up to ~500 km/h)
    // Maximum: MAX_VALID_PULSE_INTERVAL (filters stale intervals from standstill)
    if (pulseInterval <= 100 || pulseInterval >= MAX_VALID_PULSE_INTERVAL) {
        // Very long interval = standstill detected
        if (pulseInterval >= MAX_VALID_PULSE_INTERVAL) {
            hallLastTime = currentTime;
            sensorState = STANDSTILL;
            intervalBufferCount = 0;
            intervalBufferIndex = 0;
        }
        return;
    }
    
    // VR-Safe: Low-speed robustness check
    // Reject intervals < 0.4× previous filtered interval (VR edge misfires)
    // Only apply during STARTING state or very low speed to avoid false rejects
    if ((sensorState == STARTING || spdHall < LOW_SPEED_THRESHOLD_FOR_VR_REJECTION) && lastFilteredInterval > 0) {
        // Check: interval < 0.4 × lastFilteredInterval
        // Integer math: interval * 5 < lastFilteredInterval * 2
        if ((pulseInterval * 5) < (lastFilteredInterval * 2)) {
            // Reject this interval - likely a VR misfire
            return;
        }
    }
    
    // Accept interval - update timestamp and add to ring buffer
    hallLastTime = currentTime;
    lastPulseArrivalTime = currentTime;  // Track when pulse was added to buffer
    
    // Add interval to ring buffer (median filter)
    intervalBuffer[intervalBufferIndex] = pulseInterval;
    intervalBufferIndex = (intervalBufferIndex + 1) % INTERVAL_BUFFER_SIZE;
    if (intervalBufferCount < INTERVAL_BUFFER_SIZE) {
        intervalBufferCount++;
    }
    
    // State machine transitions handled in hallSpeedUpdate()
    // ISR only timestamps and enqueues - keeps it fast and deterministic
}


/**
 * hallSpeedUpdate - Handle Hall sensor timeout, state machine, and speed calculation
 * VR-Safe Combined Filter Implementation:
 * - State machine: STANDSTILL → STARTING → MOVING
 * - Median filter on pulse intervals
 * - Acceleration limiting (1g max)
 * - Speed decay when pulses slow down
 * 
 * Called every 20ms from main loop
 */
void hallSpeedUpdate() {
    static unsigned long lastUpdateTime = 0;
    static int32_t speedFilterState = 0;
    unsigned long currentTime = micros();
    unsigned long timeSinceLastPulse = currentTime - hallLastTime;
    
    // ===== TIMEOUT HANDLING =====
    // If it's been too long since last pulse, transition to STANDSTILL
    if (timeSinceLastPulse > HALL_PULSE_TIMEOUT) {
        sensorState = STANDSTILL;
        hallSpeedRaw = 0;
        spdHall = 0;
        speedFilterState = 0;
        spdHallPrev = 0;
        intervalBufferCount = 0;
        intervalBufferIndex = 0;
        lastFilteredInterval = 0;
        lastSpeedUpdateTime = currentTime;
        lastPulseArrivalTime = 0;  // Reset pulse arrival tracking
        
        // Update odometer (with speed = 0)
        if (SPEED_SOURCE == 2 && lastUpdateTime != 0) {
            unsigned long timeIntervalMicros = currentTime - lastUpdateTime;
            unsigned long timeIntervalMs = timeIntervalMicros / 1000;
            float distTraveled = updateOdometer(0, timeIntervalMs);
            if (distTraveled > 0) {
                moveOdometerMotor(distTraveled);
            }
        }
        lastUpdateTime = currentTime;
        return;
    }
    
    // ===== STATE MACHINE =====
    switch (sensorState) {
        case STANDSTILL:
            // Transition to STARTING when we have at least one interval
            if (intervalBufferCount > 0) {
                sensorState = STARTING;
                spdHall = 0;  // Don't output speed yet
            }
            break;
            
        case STARTING:
            // VR-Safe: Wait for interval coherence before outputting speed
            // This prevents spikes from unreliable initial pulses
            if (checkIntervalCoherence()) {
                sensorState = MOVING;
                // First speed output will happen in MOVING state below
            } else {
                // Not yet coherent - keep speed at zero
                spdHall = 0;
            }
            break;
            
        case MOVING:
            // Normal operation - calculate and output speed
            // This is where the median filter and acceleration limiting are applied
            break;
    }
    
    // ===== SPEED CALCULATION (MOVING state only) =====
    // Only calculate speed from buffer if we have recent pulse data
    // This prevents calculating from stale buffer data after pulses stop
    unsigned long timeSinceLastPulseArrival = currentTime - lastPulseArrivalTime;
    bool hasRecentPulse = (timeSinceLastPulseArrival < SPEED_DECAY_THRESHOLD);
    
    if (sensorState == MOVING && intervalBufferCount > 0 && hasRecentPulse) {
        // Get median interval from buffer (VR-safe: rejects outliers)
        unsigned long medianInterval = getMedianInterval();
        lastFilteredInterval = medianInterval;
        
        if (medianInterval > 0) {
            // Calculate speed in km/h * 100 using integer math
            // km/h = (pulse freq [Hz] * 3600) / (TEETH_PER_REV * REVS_PER_KM)
            // pulse freq = 1,000,000 / pulseInterval (in microseconds)
            // km/h * 100 = (1,000,000 * 3600 * 100) / (pulseInterval * TEETH_PER_REV * REVS_PER_KM)
            // Simplify: (360,000,000,000) / (pulseInterval * TEETH_PER_REV * REVS_PER_KM)
            unsigned long divisor = (unsigned long)TEETH_PER_REV * (unsigned long)REVS_PER_KM;
            unsigned int speedRaw = (unsigned int)(360000000UL / (medianInterval * divisor / 1000UL));
            hallSpeedRaw = speedRaw / 100.0;  // Keep for compatibility (MPH)
            
            speedFilterState = ema7Step((int32_t)speedRaw * 128, speedFilterState, FILTER_HALL_SPEED);
            unsigned int speedFiltered = (unsigned int)(speedFilterState / 128);
            
            // ===== ACCELERATION LIMITING =====
            // VR-Safe: Clamp acceleration to 1g max (≈ 35.3 km/h/s = 3530 in units of km/h*100/s)
            // This prevents residual spikes from passing through all other filters
            if (lastSpeedUpdateTime > 0) {
                unsigned long timeDelta = currentTime - lastSpeedUpdateTime;
                if (timeDelta > 0 && timeDelta < 1000000UL) {  // Sanity check: < 1 second
                    // Max speed change = (MAX_ACCELERATION_UNITS * timeDelta) / 1,000,000 (convert μs to s)
                    // For 20ms update: (3530 * 20000) / 1000000 = 70.6 ≈ 71 units
                    // Use 64-bit arithmetic to prevent overflow for large timeDelta
                    unsigned long maxSpeedChange = ((unsigned long long)MAX_ACCELERATION_UNITS * timeDelta) / 1000000UL;
                    
                    // Clamp speed change
                    if (speedFiltered > spdHallPrev) {
                        // Accelerating
                        unsigned int speedDelta = speedFiltered - spdHallPrev;
                        if (speedDelta > maxSpeedChange) {
                            speedFiltered = spdHallPrev + (unsigned int)maxSpeedChange;
                            speedFilterState = (int32_t)speedFiltered * 128;
                        }
                    } else {
                        // Decelerating - no clamp (allow rapid decel)
                        // Physical deceleration can exceed 1g (braking)
                    }
                }
            }
            
            spdHall = speedFiltered;
            spdHallPrev = spdHall;
            lastSpeedUpdateTime = currentTime;
        }
    }
    
    // ===== SPEED DECAY (when pulses slow down) =====
    // If pulses have slowed significantly, decay speed more aggressively
    // This prevents "hanging" at low speeds when coming to a stop
    // Only apply decay if we haven't just calculated a new speed
    if (sensorState == MOVING && timeSinceLastPulse > SPEED_DECAY_THRESHOLD && spdHall > 0 && !hasRecentPulse) {
        // Decay speed by ~10% every update cycle when no recent pulses
        // This makes the speed drop more naturally when slowing to a stop
        spdHall = (spdHall * SPEED_DECAY_FACTOR) >> 8;
        speedFilterState = (int32_t)spdHall * 128;
        spdHallPrev = spdHall;
    }
    
    // ===== MINIMUM SPEED THRESHOLD =====
    // Clamp very low speeds to zero for display stability
    if (spdHall < HALL_SPEED_MIN) {
        spdHall = 0;
        spdHallPrev = 0;
    }
    
    // ===== ODOMETER UPDATE =====
    // Update odometer based on Hall sensor speed (called every HALL_UPDATE_RATE ms)
    // Only update if Hall sensor is selected as speed source
    if (SPEED_SOURCE == 2 && lastUpdateTime != 0) {
        unsigned long timeIntervalMicros = currentTime - lastUpdateTime;
        unsigned long timeIntervalMs = timeIntervalMicros / 1000;
        // spdHall is already in km/h * 100, convert to km/h for updateOdometer
        float speedKmh = spdHall * 0.01;
        float distTraveled = updateOdometer(speedKmh, timeIntervalMs);
        if (distTraveled > 0) {
            moveOdometerMotor(distTraveled);
        }
    }
    lastUpdateTime = currentTime;
}


/**
 * updateOdometer - Calculate and update odometer based on speed and time
 * 
 * Calculates distance traveled based on current speed and time interval,
 * then updates both total and trip odometers. This function is designed
 * to be called from any speed data source (GPS, Hall sensor, or CAN).
 * 
 * @param speedKmh - Current vehicle speed in km/h
 * @param timeIntervalMs - Time elapsed since last update in milliseconds
 * 
 * Processing:
 * 1. Only integrates distance if speed > 2 km/h (reduces drift when stationary)
 * 2. Calculates distance: distance (km) = speed (km/h) * time (ms) * 2.77778e-7
 *    - Conversion factor: 1 km/h = 1000m/3600s = 0.277778 m/s = 2.77778e-7 km/ms
 * 3. Updates global odo and odoTrip variables
 * 4. Returns distance traveled for potential odometer motor movement
 * 
 * Global variables modified:
 * - odo: Total odometer reading (km)
 * - odoTrip: Trip odometer reading (km)
 * 
 * @return Distance traveled since last update in kilometers
 */
float updateOdometer(float speedKmh, unsigned long timeIntervalMs) {
    float distanceTraveled = 0;
    
    // Only integrate if speed > 2 km/h (reduces GPS drift errors when stationary)
    if (speedKmh > 2) {
        // Calculate distance traveled: distance (km) = speed (km/h) * time (ms) * conversion factor
        // Conversion: 1 km/h = 1000m/3600s = 0.277778 m/s = 2.77778e-7 km/ms
        distanceTraveled = speedKmh * timeIntervalMs * 2.77778e-7;
    }
    
    // Update odometers
    odo = odo + distanceTraveled;
    odoTrip = odoTrip + distanceTraveled;
    
    return distanceTraveled;
}

/**
 * ignitionPulseISR - Interrupt service routine for engine RPM measurement
 * 
 * ISR Design: Lightweight with minimal calculation
 * - Captures pulse timestamp using micros()
 * - Debounces using RPM_DEBOUNCE_MICROS to suppress coil-ringdown echoes
 * - Calculates pulse interval
 * - Computes RPM using integer math and division
 * - Applies plausibility check to reject spikes (>50% change when RPM > 500)
 * - Applies exponential moving average filter
 * 
 * Performance: ~10-15 µs execution time
 * 
 * Note: Division in ISR is not ideal but acceptable here because:
 * - Engine pulses are relatively infrequent (max ~300 Hz at 18k RPM)
 * - Calculation is simple enough to complete quickly
 * - No complex loops or blocking operations
 * 
 * Alternative considered but not implemented:
 * - Could defer division to main loop (capture interval only in ISR)
 * - Current approach is simpler and performs adequately
 */
void ignitionPulseISR() {
    unsigned long currentTime = micros();
    unsigned long pulseInterval = currentTime - ignitionLastTime;

    // Debounce: reject pulses arriving sooner than RPM_DEBOUNCE_MICROS after the last
    // accepted pulse. This suppresses coil-ringdown echoes that cause spurious RPM spikes.
    // ignitionLastTime is intentionally NOT updated here so the next real pulse is measured
    // from the correct baseline.
    if (pulseInterval < RPM_DEBOUNCE_MICROS) {
        return;
    }

    ignitionLastTime = currentTime;

    // Calculate RPM using integer math:
    // RPM = (1,000,000 μs/sec * 120 sec/2min) / (pulseInterval * CYL_COUNT)
    // RPM = 120,000,000 / (pulseInterval * CYL_COUNT)
    // Note: CYL_COUNT is 2x old PULSES_PER_REVOLUTION, so we use 120M instead of 60M
    int rpmRaw = (int)(120000000UL / (pulseInterval * CYL_COUNT));

    // Plausibility check: reject RPM spikes.
    // Compare against the last accepted raw reading, not the lagging EMA, so
    // heavy filtering does not cause normal startup pulses to be rejected.
    // Note: engine shutdown is handled by engineRPMUpdate() which resets RPM to
    // zero after IGNITION_PULSE_TIMEOUT (500 ms) of no pulses, independently of
    // this check, so a stopped engine will never be held at a high RPM value.
    if (engineRPMRaw > 500) {
        int32_t halfRaw = engineRPMRaw >> 1;
        if (rpmRaw > (int32_t)engineRPMRaw + halfRaw || rpmRaw < (int32_t)engineRPMRaw - halfRaw) {
            return;  // Spike detected – hold previous reading
        }
    }

    engineRPMRaw = rpmRaw;

    rpmFilterState = ema7Step((int32_t)rpmRaw * 128, rpmFilterState, FILTER_ENGINE_RPM);
    engineRPMEMA = (int)(rpmFilterState / 128);

    // Uncomment for debugging (note: Serial.print in ISR can cause timing issues)
    // Serial.print("RPM: ");
    // Serial.println(engineRPMEMA);
}

/**
 * engineRPMUpdate - Handle engine RPM timeout and minimum threshold
 */
void engineRPMUpdate() {
    ATOMIC_BLOCK(ATOMIC_RESTORESTATE) {
        unsigned long currentTime = micros();
        if ((currentTime - ignitionLastTime) > IGNITION_PULSE_TIMEOUT) {
            engineRPMRaw = 0;
            engineRPMEMA = 0;
            rpmFilterState = 0;
        }
        if (engineRPMEMA < ENGINE_RPM_MIN) {
            engineRPMEMA = 0;
        }
    }
}

/**
 * curveLookup - Generic lookup table with linear interpolation (float version)
 */
float curveLookup(float input, float brkpts[], float curve[], int curveLength){
  int index = 1;

  // Find input's position within the breakpoints
  for (int i = 0; i <= curveLength-1; i++){
    if (input < brkpts[0]){
      // Input below range - return minimum value (flat extrapolation)
      float output = curve[0];
      return output;
    } 
    else if (input <= brkpts[i+1]){
      // Found the interval containing input value
      index = i+1;
      break;
    } 
    else if (input > brkpts[curveLength-1]){
      // Input above range - return maximum value (flat extrapolation)
      float output = curve[curveLength-1];
      return output;
    }
  } 

  // Linear interpolation between breakpoints at index-1 and index
  float x1 = brkpts[index];      // Upper breakpoint X
  float x0 = brkpts[index-1];    // Lower breakpoint X
  float y1 = curve[index];       // Upper breakpoint Y
  float y0 = curve[index-1];     // Lower breakpoint Y
  
  // Calculate interpolated value: slope * distance + offset
  float output = (((y1-y0)/(x1-x0))*(input-x0))+y0;
  return output;
}

/**
 * curveLookup - Integer overload for uint16_t x-axis (millivolts) and int16_t y-axis
 *
 * Used with the compact thermistor table (thermTable_x / thermTable_l).
 * Identical interpolation logic to the float version.
 *
 * @param input      - Input value in millivolts (uint16_t)
 * @param brkpts     - Breakpoint array in millivolts
 * @param curve      - Y-value array (int16_t, e.g. °C)
 * @param curveLength - Number of table entries
 * @return Interpolated float result
 */
float curveLookup(uint16_t input, const uint16_t brkpts[], const int16_t curve[], int curveLength) {
    if (input < brkpts[0]) return (float)curve[0];
    if (input >= brkpts[curveLength - 1]) return (float)curve[curveLength - 1];
    for (int i = 0; i < curveLength - 1; i++) {
        if (input <= brkpts[i + 1]) {
            float x0 = (float)brkpts[i],     x1 = (float)brkpts[i + 1];
            float y0 = (float)curve[i],       y1 = (float)curve[i + 1];
            return ((y1 - y0) / (x1 - x0)) * ((float)input - x0) + y0;
        }
    }
    return (float)curve[curveLength - 1];
}

/**
 * curveLookup - Integer overload for uint16_t x-axis (millivolts) and uint8_t y-axis (value*10)
 *
 * Used with the compact fuel level table (fuelLvlTable_x / fuelLvlTable_l).
 * Y values are stored as (gallons * 10); this function divides by 10 before returning
 * so the caller receives gallons directly.
 *
 * @param input      - Input value in millivolts (uint16_t)
 * @param brkpts     - Breakpoint array in millivolts
 * @param curve      - Y-value array (uint8_t, gallons * 10)
 * @param curveLength - Number of table entries
 * @return Interpolated float result in gallons
 */
float curveLookup(uint16_t input, const uint16_t brkpts[], const uint8_t curve[], int curveLength) {
    if (input < brkpts[0]) return curve[0] / 10.0f;
    if (input >= brkpts[curveLength - 1]) return curve[curveLength - 1] / 10.0f;
    for (int i = 0; i < curveLength - 1; i++) {
        if (input <= brkpts[i + 1]) {
            float x0 = (float)brkpts[i],     x1 = (float)brkpts[i + 1];
            float y0 = (float)curve[i],       y1 = (float)curve[i + 1];
            return (((y1 - y0) / (x1 - x0)) * ((float)input - x0) + y0) / 10.0f;
        }
    }
    return curve[curveLength - 1] / 10.0f;
}

/**
 * sigSelect - Process and route sensor data
 */
void sigSelect (void) {
    // Select vehicle speed source: 0=off, 1=CAN, 2=Hall sensor, 3=GPS, 4=Synthetic (debug), 5=Odometer test
    switch (SPEED_SOURCE) {
        case 0:  // Off
            spd = 0;
            break;
        case 1:  // CAN speed source
            spd = spdCAN;  // Already in km/h * 100 format
            break;
        case 2:  // Hall sensor speed source
            spd = spdHall;  // Already in km/h * 100 format
            break;
        case 3:  // GPS speed source
            spd = spdGPS;  // Already in km/h * 100 format
            break;
        case 4:  // Synthetic speed source (for debugging)
            spd = generateSyntheticSpeed();  // Returns km/h * 100 format
            break;
        case 5:  // Odometer accuracy test: deterministic 1-mile profile
            spd = generateOdometerTestSpeed();  // Returns km/h * 100 format
            break;
        case 6:  // Serial signal source: speed set via serial commands
            spd = spdSerial;  // Already in km/h * 100 format
            break;
        default:  // Fallback to off
            spd = 0;
            break;
    }
    
    // Update odometer for CAN speed source
    // (GPS and Hall sensor update odometer in their respective functions)
    if (SPEED_SOURCE == 1 && lastCANOdometerUpdateTime != 0) {
        unsigned long currentTime = millis();
        unsigned long timeIntervalMs = currentTime - lastCANOdometerUpdateTime;
        // spdCAN is in km/h * 100 format, convert to km/h for updateOdometer
        float speedKmh = spdCAN * 0.01;
        float distTraveled = updateOdometer(speedKmh, timeIntervalMs);
        if (distTraveled > 0) {
            moveOdometerMotor(distTraveled);
        }
        lastCANOdometerUpdateTime = currentTime;
    } else if (SPEED_SOURCE == 1 && lastCANOdometerUpdateTime == 0) {
        // Initialize the timer on first run
        lastCANOdometerUpdateTime = millis();
    }
    
    // Update odometer for synthetic speed source (for debugging)
    if ((SPEED_SOURCE == 4 || SPEED_SOURCE == 5) && lastSyntheticOdometerUpdateTime != 0) {
        unsigned long currentTime = millis();
        unsigned long timeIntervalMs = currentTime - lastSyntheticOdometerUpdateTime;
        // spd is in km/h * 100 format, convert to km/h for updateOdometer
        float speedKmh = spd * 0.01;
        float distTraveled = updateOdometer(speedKmh, timeIntervalMs);
        if (distTraveled > 0) {
            moveOdometerMotor(distTraveled);
        }
        lastSyntheticOdometerUpdateTime = currentTime;
    } else if ((SPEED_SOURCE == 4 || SPEED_SOURCE == 5) && lastSyntheticOdometerUpdateTime == 0) {
        // Initialize the timer on first run
        lastSyntheticOdometerUpdateTime = millis();
    }
    
    // Update odometer for serial speed source
    if (SPEED_SOURCE == 6 && lastSerialOdometerUpdateTime != 0) {
        unsigned long currentTime = millis();
        unsigned long timeIntervalMs = currentTime - lastSerialOdometerUpdateTime;
        // spd is in km/h * 100 format, convert to km/h for updateOdometer
        float speedKmh = spd * 0.01;
        float distTraveled = updateOdometer(speedKmh, timeIntervalMs);
        if (distTraveled > 0) {
            moveOdometerMotor(distTraveled);
        }
        lastSerialOdometerUpdateTime = currentTime;
    } else if (SPEED_SOURCE == 6 && lastSerialOdometerUpdateTime == 0) {
        // Initialize the timer on first run
        lastSerialOdometerUpdateTime = millis();
    }
    
    // Select engine RPM source: 0=off, 1=CAN, 2=coil negative, 3=synthetic (debug), 4=Serial
    switch (RPM_SOURCE) {
        case 0:  // Off
            RPM = 0;
            break;
        case 1:  // CAN RPM source
            RPM = rpmCAN;
            break;
        case 2:  // Coil negative tachometer
            RPM = engineRPMEMA;
            break;
        case 3:  // Synthetic RPM (debug)
            RPM = generateRPM();  // Returns RPM value
            break;
        case 4:  // Serial signal source: RPM set via serial commands
            RPM = rpmSerial;
            break;
        default:  // Fallback to off
            RPM = 0;
            break;
    }
    
    // Select oil pressure source: 0=off, 1=CAN, 2=sensor_av1, 3=sensor_av2, 4=sensor_av3, 5=synthetic (debug)
    switch (OIL_PRS_SOURCE) {
        case 0:  // Off
            oilPrs = 0;
            break;
        case 1:  // CAN oil pressure
            oilPrs = (oilPrsCAN/10.0) - 101.3;  // Convert from absolute kPa to gauge pressure
            break;
        case 2:  // Analog sensor AV1 (pressure sensor per AVn_TYPE)
            oilPrs = avGaugeKpa(sensor_av1);
            break;
        case 3:  // Analog sensor AV2 (pressure sensor per AVn_TYPE)
            oilPrs = avGaugeKpa(sensor_av2);
            break;
        case 4:  // Analog sensor AV3 (pressure sensor per AVn_TYPE)
            oilPrs = avGaugeKpa(sensor_av3);
            break;
        case 5:  // Synthetic oil pressure (debug)
            oilPrs = generateSyntheticOilPressure();
            break;
        case 6:  // Serial signal source
            oilPrs = oilPrsSerial;
            break;
        default:  // Fallback to off
            oilPrs = 0;
            break;
    }
    
    // Select fuel pressure source: 0=off, 1=CAN, 2=sensor_av1, 3=sensor_av2, 4=sensor_av3, 5=synthetic (debug)
    switch (FUEL_PRS_SOURCE) {
        case 0:  // Off
            fuelPrs = 0;
            break;
        case 1:  // CAN fuel pressure
            fuelPrs = (fuelPrsCAN/10.0) - 101.3;  // Convert from absolute kPa to gauge pressure
            break;
        case 2:  // Analog sensor AV1 (pressure sensor per AVn_TYPE)
            fuelPrs = avGaugeKpa(sensor_av1);
            break;
        case 3:  // Analog sensor AV2 (pressure sensor per AVn_TYPE)
            fuelPrs = avGaugeKpa(sensor_av2);
            break;
        case 4:  // Analog sensor AV3 (pressure sensor per AVn_TYPE)
            fuelPrs = avGaugeKpa(sensor_av3);
            break;
        case 5:  // Synthetic fuel pressure (debug)
            fuelPrs = generateSyntheticFuelPressure();
            break;
        default:  // Fallback to off
            fuelPrs = 0;
            break;
    }
    
    // Select coolant temperature source: 0=off, 1=CAN, 2=therm, 3=synthetic (debug)
    switch (COOLANT_TEMP_SOURCE) {
        case 0:  // Off
            coolantTemp = 0;
            break;
        case 1:  // CAN coolant temperature
            coolantTemp = (coolantTempCAN/10.0) - 273.15;  // Convert from Kelvin*10 to Celsius
            break;
        case 2:  // Thermistor sensor
            coolantTemp = therm;
            break;
        case 3:  // Synthetic coolant temperature (debug)
            coolantTemp = generateSyntheticCoolantTemp();
            break;
        case 4:  // Serial signal source
            coolantTemp = coolantTempSerial;
            break;
        default:  // Fallback to off
            coolantTemp = 0;
            break;
    }
    
    // Select oil temperature source: 0=off, 1=CAN, 2=therm
    switch (OIL_TEMP_SOURCE) {
        case 0:  // Off
            oilTemp = 0;
            break;
        case 1:  // CAN oil temperature
            oilTemp = oilTempCAN / 10.0;  // Convert from Celsius*10 to Celsius
            break;
        case 2:  // Thermistor sensor
            oilTemp = therm;
            break;
        default:  // Fallback to off
            oilTemp = 0;
            break;
    }
    
    // Select manifold pressure/boost source: 0=off, 1=CAN, 2=sensor_av1, 3=sensor_av2, 4=sensor_av3, 5=synthetic (debug)
    switch (MAP_SOURCE) {
        case 0:  // Off
            manifoldPrs = 0;
            break;
        case 1:  // CAN manifold pressure
            manifoldPrs = mapCAN / 10.0;  // Convert from kPa*10 to kPa
            break;
        case 2:  // Analog sensor AV1
            manifoldPrs = avAbsoluteKpa(sensor_av1);
            break;
        case 3:  // Analog sensor AV2
            manifoldPrs = avAbsoluteKpa(sensor_av2);
            break;
        case 4:  // Analog sensor AV3
            manifoldPrs = avAbsoluteKpa(sensor_av3);
            break;
        case 5:  // Synthetic manifold pressure (debug)
            manifoldPrs = generateSyntheticManifoldPressure();
            break;
        default:  // Fallback to off
            manifoldPrs = 0;
            break;
    }
    
    // Select Lambda/AFR source: 0=off, 1=CAN, 2=sensor_av1, 3=sensor_av2, 4=sensor_av3
    switch (LAMBDA_SOURCE) {
        case 0:  // Off
            afr = 0;
            break;
        case 1:  // CAN Lambda/AFR
            afr = afr1CAN / 1000.0;  // Convert from AFR*1000 to AFR
            break;
        case 2:  // Analog sensor AV1
            afr = (AV1_TYPE == AV_TYPE_NONE) ? sensor_av1 / 100.0 : sensor_av1 / 1000.0;  // Raw volts*100, or Lambda*1000
            break;
        case 3:  // Analog sensor AV2
            afr = (AV2_TYPE == AV_TYPE_NONE) ? sensor_av2 / 100.0 : sensor_av2 / 1000.0;
            break;
        case 4:  // Analog sensor AV3
            afr = (AV3_TYPE == AV_TYPE_NONE) ? sensor_av3 / 100.0 : sensor_av3 / 1000.0;
            break;
        default:  // Fallback to off
            afr = 0;
            break;
    }
    
    // These remain unchanged as they don't have alternate sources
    fuelComp = fuelCompCAN/10.0;  // Fuel composition - divide by 10 (e.g., 850 becomes 85%)

    // Select fuel level source: 0=off, 1=analog sensor, 2=Synthetic (debug)
    switch (FUEL_LVL_SOURCE) {
        case 0:  // Off
            fuelLvl = 0;
            break;
        case 1:  // Analog fuel level sensor
            {
                // fuelSensorRaw is 0-500 (mapped ADC); multiply by 10 to get millivolts (0-5000).
                // Piecewise linear through empty (0%), mid (FUEL_MID_PCT) and full (100%).
                // Works for senders whose voltage rises or falls toward full (fuelLvlTable is no longer used).
                float dir = (FUEL_V_FULL_MV >= FUEL_V_EMPTY_MV) ? 1.0f : -1.0f;
                float x  = fuelSensorRaw * 10.0f * dir;
                float xe = FUEL_V_EMPTY_MV * dir;
                float xm = FUEL_V_MID_MV * dir;
                float xf = FUEL_V_FULL_MV * dir;
                float pct;
                if (x <= xm) {
                    pct = (xm == xe) ? 0.0f : FUEL_MID_PCT * (x - xe) / (xm - xe);
                } else {
                    pct = (xf == xm) ? 100.0f : FUEL_MID_PCT + (100.0f - FUEL_MID_PCT) * (x - xm) / (xf - xm);
                }
                fuelLvl = constrain(pct, 0.0f, 100.0f);
            }
            break;
        case 2:  // Synthetic fuel level (debug)
            fuelLvl = generateSyntheticFuelLevel();
            break;
        case 3:  // Serial signal source (percent of capacity)
            fuelLvl = fuelLvlSerial;
            break;
        default:  // Fallback to off
            fuelLvl = 0;
            break;
    }

    fuelLvlCAN = (int)fuelLvl;  // fuelLvl is already percent

    // Set boost pressure to manifold absolute pressure for display
    // Note: Called "boost" for simplicity, but displays absolute manifold pressure (MAP)
    // Typical atmospheric pressure is ~101.325 kPa, so:
    // - Values below atmospheric indicate vacuum/throttling
    // - Values above atmospheric indicate forced induction (turbo/supercharger)
    boostPrs = manifoldPrs;

}
