125jdavis/gauge/gauge_V4/globals.cpp

/*
 * ========================================
 * GLOBAL VARIABLE DEFINITIONS
 * ========================================
 */

#include "globals.h"

// ===== HARDWARE OBJECT INSTANCES =====
MCP_CAN CAN0(CAN0_CS);
Adafruit_SSD1306 display1(SCREEN_W, SCREEN_H, &SPI, OLED_DC_1, OLED_RST_1, OLED_CS_1);
Adafruit_SSD1306 display2(SCREEN_W, SCREEN_H, &SPI, OLED_DC_2, OLED_RST_2, OLED_CS_2);
Rotary rotary = Rotary(2, 3);
CRGB leds[MAX_LEDS];
SwitecX12 motor1(M1_SWEEP, M1_STEP, M1_DIR);
SwitecX12 motor2(M2_SWEEP, M2_STEP, M2_DIR);
SwitecX12 motor3(M3_SWEEP, M3_STEP, M3_DIR);
SwitecX12 motor4(M4_SWEEP, M4_STEP, M4_DIR);
SwitecX12 motorS(MS_SWEEP, MS_STEP, MS_DIR);
// Note: odoMotor no longer uses Arduino Stepper library
// Direct pin control is used in outputs.cpp for non-blocking operation
Adafruit_GPS GPS(&Serial2);

// ===== ANALOG SENSOR READINGS =====
float vBatt = 12;              // Current battery voltage in volts (filtered)
int vBattRaw = 12;             // Raw battery reading (0-500, representing 0-5V after mapping)
int fuelSensorRaw;             // Raw fuel sensor ADC reading (0-500)
float therm;                   // Current temperature in Celsius (after lookup table conversion)
float thermSensor;             // Voltage reading from thermistor (0-5V)
int thermCAN;                  // Temperature formatted for CAN transmission (temp * 10)
float sensor_av1;              // Analog AV1 reading; units depend on selected source
float sensor_av2;              // Analog AV2 reading; units depend on selected source
float sensor_av3;              // Analog AV3 reading; units depend on selected source

// ===== HALL EFFECT SPEED SENSOR VARIABLES =====
volatile unsigned long hallLastTime = 0;     // Last pulse time (micros)
volatile float hallSpeedRaw = 0;             // Most recent calculated speed (MPH)
unsigned int spdHall = 0;                    // Filtered speed (km/h * 100)

// ===== ENGINE RPM SENSOR VARIABLES =====
volatile unsigned long ignitionLastTime = 0; // Last ignition pulse time (micros)
volatile int engineRPMRaw = 0;               // Most recent calculated RPM (unfiltered)
volatile int engineRPMEMA = 0;               // Filtered RPM with exponential moving average

// ===== GPS SPEED AND ODOMETER VARIABLES =====
// GPS provides speed and time data for speedometer and odometer calculations
unsigned long v_old = 0;       // Previous GPS speed reading (km/h * 100)
unsigned long spdGPS = 1;      // Current GPS speed reading (km/h * 100)
unsigned long t_old = 0;       // Previous GPS timestamp (milliseconds)
unsigned long t_new = 1;       // Current GPS timestamp (milliseconds)
unsigned long v_100 = 0;       // Speed value * 100 for integer math precision
float v = 0;                   // Current speed in km/h (floating point)
bool usingInterrupt = false;   // Flag indicating if GPS uses interrupt-based reading
int lagGPS;                    // Time delay since last GPS update (milliseconds)
int v_g;                       // GPS speed (alternate variable)
float odo;                     // Total odometer reading in kilometers (saved to EEPROM)
float odoTrip;                 // Trip odometer in kilometers (resettable, saved to EEPROM)
float distLast;                // Distance traveled since last GPS update (km)
byte hour;                     // Current GPS hour (UTC, 0-23)
byte minute;                   // Current GPS minute (0-59)

// ===== STEPPER MOTOR POSITION VARIABLES =====
// Target positions calculated from sensor data for smooth needle movement
unsigned int spd_g;            // Speedometer target value (mph * 100)
unsigned int fuelLevelPct_g;   // Fuel level percentage * 10
unsigned int coolantTemp_g;    // Coolant temperature for gauge calculation

// ===== ROTARY ENCODER VARIABLES =====
// Handle menu navigation via rotary encoder with debouncing
// NOTE: stateSW, lastStateSW, lastStateChangeTime, debounceDelay, and debounceFlag
// are now declared as static locals inside swRead() function (not globals)
// to prevent potential interference from other parts of the code
bool button = 0;                       // Button press event flag (set when press completes)
volatile bool encoderMoved = false;    // Flag set when encoder rotates (for immediate display update)

// ===== TIMING VARIABLES =====
// Manage update rates for different subsystems
unsigned long timer0, timerDispUpdate, timerCANsend;
unsigned long timerSensorRead, timerTachUpdate, timerTachFlash;
unsigned long timerCheckGPS, timerGPSupdate, timerAngleUpdate;
unsigned long timerHallUpdate;
unsigned long timerEngineRPMUpdate;
unsigned long timerSigSelectUpdate;

// ===== OBDII POLLING VARIABLES =====
unsigned long timerOBDIIPriority1 = 0;  // Timer for 10Hz priority 1 polls (vehicle speed, RPM, lambda, MAP)
unsigned long timerOBDIIPriority2 = 0;  // Timer for 1Hz priority 2 polls (coolant temp, oil temp)
bool obdiiAwaitingResponse = false;     // Flag indicating waiting for OBDII response
uint8_t obdiiCurrentPID = 0;            // Current PID being polled
// ===== CAN BUS ENGINE PARAMETERS =====
// Raw values received from Haltech ECU via CAN bus
// These are stored as integers to preserve precision from the CAN protocol
int rpmCAN;                // Engine RPM (direct value, 0-10000+)
int mapCAN;                // Manifold Absolute Pressure in kPa * 10 (e.g., 1000 = 100.0 kPa)
int tpsCAN;                // Throttle Position Sensor percentage * 10 (e.g., 750 = 75.0%)
int fuelPrsCAN;            // Fuel pressure in kPa * 10 (absolute pressure)
int oilPrsCAN;             // Oil pressure in kPa * 10 (absolute pressure)
int injDutyCAN;            // Injector duty cycle percentage * 10 (e.g., 800 = 80.0%)
int ignAngCAN;             // Ignition timing in degrees BTDC * 10 (e.g., 150 = 15.0°)
int afr1CAN;               // Air/Fuel Ratio * 1000 (e.g., 14700 = 14.700 AFR)
int knockCAN;              // Knock sensor level (higher = more knock detected)
int coolantTempCAN;        // Coolant temperature in Kelvin * 10 (convert to C: (value/10) - 273.15)
int airTempCAN;            // Intake Air Temperature in Kelvin * 10
int fuelTempCAN;           // Fuel temperature in Kelvin * 10
int oilTempCAN;            // Oil temperature in Celsius * 10
int transTempCAN;          // Transmission temperature in Celsius * 10
int fuelCompCAN;           // Fuel composition (ethanol %) * 10 (e.g., 850 = 85.0% E85)
int fuelLvlCAN;            // Fuel level percentage (0-100)
int baroCAN;               // Barometric pressure in kPa * 10 (sent TO other modules)
int spdCAN;                // Vehicle speed sent to CAN bus (km/h * 16 for protocol compatibility)
int pumpPressureCAN;       // Fuel pump pressure (test variable)

// ===== PROCESSED ENGINE PARAMETERS FOR DISPLAY =====
// Converted from CAN values to human-readable units
float oilPrs = 25;         // Oil pressure in kPa (gauge pressure, atmospheric offset removed)
float coolantTemp = 0;     // Coolant temperature in Celsius
float fuelPrs = 43;        // Fuel pressure in kPa (gauge pressure)
float oilTemp = 0;         // Oil temperature in Celsius
float fuelLvl = 0;         // Fuel level in percent of capacity (0-100)
float battVolt = 12.6;     // Battery voltage in volts
float afr = 14.2;          // Air/Fuel Ratio (stoichiometric for gasoline ~14.7)
float fuelComp = 0;        // Ethanol percentage (0-100%)
float manifoldPrs = 101.3; // Manifold Absolute Pressure in kPa (default to atmospheric)
float boostPrs = 101.3;    // Boost pressure display (actually MAP for ease of use)
int RPM = 0;               // Engine RPM for display
int spd = 0;               // Vehicle speed in km/h * 100 (for integer precision)
float spdMph = 0;          // Vehicle speed in miles per hour

// ===== SERIAL SIGNAL SOURCE VARIABLES =====
int spdSerial = 0;         // Speed set via serial (km/h * 100), used when SPEED_SOURCE == 6
int rpmSerial = 0;         // RPM set via serial, used when RPM_SOURCE == 4
float oilPrsSerial = 0;    // Oil pressure (kPa gauge) set via serial, used when OIL_PRS_SOURCE == 6
float coolantTempSerial = 0; // Coolant temperature (Celsius) set via serial, used when COOLANT_TEMP_SOURCE == 4
float fuelLvlSerial = 0;   // Fuel level (% of capacity) set via serial, used when FUEL_LVL_SOURCE == 3


// ===== CAN BUS COMMUNICATION BUFFERS =====
// Buffers for sending and receiving CAN messages
// Note: data buffer moved to local in sendCAN_LE() and sendCAN_BE() functions
byte canMessageData [8] = {0x00, 0x00, 0x00, 0x00, 0x00, 0x00, 0x00, 0x00}; // Received CAN message data
unsigned long rxId;                // Received CAN message ID (11-bit or 29-bit)
unsigned char len = 0;             // Length of received CAN message (0-8 bytes)
unsigned char rxBuf[8];            // Raw receive buffer from CAN controller

// ===== LOOKUP TABLES =====
// These tables convert non-linear sensor readings to physical values using interpolation

// Thermistor Temperature Lookup Table
// Converts voltage reading (x-axis) to temperature in Celsius (y-axis)
// GM thermistors have a non-linear resistance curve that varies with temperature
const int thermTable_length = 6;
uint16_t thermTable_x[thermTable_length] = {89, 277, 656, 2852, 4120, 4874};  // Voltage breakpoints (millivolts)
int16_t  thermTable_l[thermTable_length] = {150,  105,   75,   25,   -5,  -40};  // Temperature values in Celsius

// Fuel Level Lookup Table
// Converts voltage reading (x-axis) to fuel quantity in gallons (y-axis)
// Fuel tank sender has non-linear float arm resistance
// fuelLvlTable_l stores gallons * 10 for 0.1-gallon precision using uint8_t
const int fuelLvlTable_length = 9;
const uint16_t fuelLvlTable_x[fuelLvlTable_length] = {870, 1030, 1210, 1400, 1600, 1970, 2210, 2250, 2300};  // Voltage breakpoints (millivolts)
const uint8_t  fuelLvlTable_l[fuelLvlTable_length] = {160,  140,  120,  100,   80,   60,   40,   20,    0};  // Gallons * 10 remaining

// ===== EEPROM STORAGE ADDRESSES =====
// Non-volatile memory locations for saving settings between power cycles
byte dispArray1Address = 0;      // Display 1 menu selections (4 bytes: addresses 0-3)
byte dispArray2Address = 4;      // Display 2 selection (1 byte: address 4)
byte clockOffsetAddress = 5;     // Time zone offset for clock (1 byte: address 5)
byte odoAddress = 6;             // Total odometer value (4 bytes: addresses 6-9)
byte odoTripAddress = 10;        // Trip odometer value (4 bytes: addresses 10-13)
byte fuelSensorRawAddress = 14;  // Last fuel sensor reading (for fuel level memory, addresses 14-17)
byte unitsAddress = 18;          // Unit system selection: 0=metric, 1=imperial (1 byte: address 18)
uint16_t disp1ListAddress = 20;  // Display 1 screen list (1 count byte + 17 IDs: addresses 20-37)
uint16_t disp2ListAddress = 38;  // Display 2 screen list (1 count byte + 17 IDs: addresses 38-55)
// Addresses 56-65: tach configuration; 66-76: colors; 77-80: flash RPM; 81-508 reserved.
uint16_t splashValidFlag1Address = 509;  // Splash slot 1 validity flag (0xA5 = valid)
uint16_t splashValidFlag2Address = 510;  // Splash slot 2 validity flag (0xA5 = valid)
// Address 511: reserved padding byte
uint16_t customSplash1Address = 512;     // Custom splash image slot 1 (512 bytes: 512-1023)
uint16_t customSplash2Address = 1024;    // Custom splash image slot 2 (512 bytes: 1024-1535)

// ===== MENU NAVIGATION VARIABLES =====
// Track current position in the multi-level menu system
byte menuLevel = 0;              // Current menu depth (0=top level, 1=submenu, 2=sub-submenu)
byte units = 0;                  // Unit system: 0=metric (km/h, C, bar), 1=imperial (mph, F, PSI)
unsigned int nMenuLevel = 17;    // Maximum menu index (0-17 = 18 total items)
byte dispArray1[4] = { 1, 0, 0, 0 };  // Menu position array for display 1 [level0, level1, level2, level3]
byte dispArray2[1] = {1};        // Screen ID shown on display 2 (same IDs as display 1, 1-17)

// Ordered, user-selected screen lists (screen IDs 1-17; Settings is always appended on display 1)
// IDs 13 and 14 (Injector Duty, Ignition Timing) are retired and never listed
byte disp1List[MAX_SCREEN_LIST] = {1, 2, 3, 4, 5, 6, 7, 8, 9, 10, 11, 12, 15, 16, 17};
byte disp1Count = 15;
byte disp2List[MAX_SCREEN_LIST] = {1, 2, 3, 4, 5, 6, 7, 8, 9, 10, 11, 12, 15, 16, 17};
byte disp2Count = 15;

// ===== DISPLAY OPTIMIZATION VARIABLES =====
// Previous values for dirty tracking - detect when values change enough to warrant display update
float oilPrs_prev = 0;           // Previous oil pressure for dirty tracking
float coolantTemp_prev = 0;      // Previous coolant temp for dirty tracking
float oilTemp_prev = 0;          // Previous oil temp for dirty tracking
float fuelPrs_prev = 0;          // Previous fuel pressure for dirty tracking
float fuelLvl_prev = 0;          // Previous fuel level for dirty tracking
float vBatt_prev = 0;            // Previous battery voltage for dirty tracking
float afr_prev = 0;              // Previous AFR for dirty tracking
float fuelComp_prev = 0;         // Previous fuel composition for dirty tracking
float boostPrs_prev = 0;         // Previous boost pressure for dirty tracking
int RPM_prev = 0;                // Previous RPM for dirty tracking
int spd_prev = 0;                // Previous speed for dirty tracking
byte hour_prev = 0;              // Previous hour for clock dirty tracking
byte minute_prev = 0;            // Previous minute for clock dirty tracking
byte dispArray1_prev[4] = {0, 0, 0, 0}; // Previous display 1 menu state
byte dispArray2_prev = 0;        // Previous display 2 selection
bool staticContentDrawn1 = false; // Flag: static content drawn on display1
bool staticContentDrawn2 = false; // Flag: static content drawn on display2

// Variable refresh rate timers
unsigned long timerDisp1Update = 0;  // Timer for display 1 updates
unsigned long timerDisp2Update = 0;  // Timer for display 2 updates

// ===== FAULT FLASH STATE =====
unsigned long timerFaultFlash = 0;   // Timer for fault display flash toggle
bool faultFlashState = false;        // Current inversion state for fault flash (true = inverted)

// ===== FAULT DEBOUNCE STATE =====
// Each fault timer is reset to millis() while the raw condition is false.
// The confirmed flag becomes true only after the raw condition has been
// continuously true for FAULT_DEBOUNCE_MS.
unsigned long timerOilFaultDebounce     = 0;
unsigned long timerCoolantFaultDebounce = 0;
unsigned long timerBattFaultDebounce    = 0;
unsigned long timerFuelFaultDebounce    = 0;
bool oilFaultActive     = false;  // Debounced oil pressure fault
bool coolantFaultActive = false;  // Debounced coolant temperature fault
bool battFaultActive    = false;  // Debounced battery voltage fault
bool fuelFaultActive    = false;  // Debounced low fuel fault
