125jdavis/gauge/gauge_V4/globals.h

/*
 * ========================================
 * GLOBAL VARIABLE DECLARATIONS
 * ========================================
 * 
 * Global variables used throughout the gauge system
 * Following STYLE.MD: variables use lowerCamelCase
 */

#ifndef GLOBALS_H
#define GLOBALS_H

#include <Arduino.h>
#include <Adafruit_SSD1306.h>
#include <Adafruit_GPS.h>
#include <mcp_can.h>
#include <SwitecX12.h>
#define HALF_STEP
#include <Rotary.h>
#include <FastLED.h>
#include "config_hardware.h"
#include "config_calibration.h"

// ===== HARDWARE OBJECT INSTANCES =====
extern MCP_CAN CAN0;
extern Adafruit_SSD1306 display1;
extern Adafruit_SSD1306 display2;
extern Rotary rotary;
extern CRGB leds[MAX_LEDS];
extern SwitecX12 motor1;
extern SwitecX12 motor2;
extern SwitecX12 motor3;
extern SwitecX12 motor4;
extern SwitecX12 motorS;
// Note: odoMotor no longer uses Arduino Stepper library
// Direct pin control is used in outputs.cpp for non-blocking operation
extern Adafruit_GPS GPS;

// ===== ANALOG SENSOR READINGS =====
extern float vBatt;                 // Current battery voltage in volts (filtered)
extern int vBattRaw;                // Raw battery reading (0-500, representing 0-5V after mapping)
extern int fuelSensorRaw;           // Raw fuel sensor ADC reading (0-500)
extern float therm;                 // Current temperature in Celsius (after lookup table conversion)
extern float thermSensor;           // Voltage reading from thermistor (0-5V)
extern int thermCAN;                // Temperature formatted for CAN transmission (temp * 10)
extern float sensor_av1;            // Analog AV1 reading; units depend on selected source
extern float sensor_av2;            // Analog AV2 reading; units depend on selected source
extern float sensor_av3;            // Analog AV3 reading; units depend on selected source

// ===== HALL EFFECT SPEED SENSOR VARIABLES =====
extern volatile unsigned long hallLastTime;     // Last pulse time (micros)
extern volatile float hallSpeedRaw;             // Most recent calculated speed (MPH)
extern unsigned int spdHall;                    // Filtered speed (km/h * 100)

// ===== ENGINE RPM SENSOR VARIABLES =====
extern volatile unsigned long ignitionLastTime; // Last ignition pulse time (micros)
extern volatile int engineRPMRaw;               // Most recent calculated RPM (unfiltered)
extern volatile int engineRPMEMA;               // Filtered RPM with exponential moving average

// ===== GPS SPEED AND ODOMETER VARIABLES =====
extern unsigned long v_old;         // Previous GPS speed reading (km/h * 100)
extern unsigned long spdGPS;        // Current GPS speed reading (km/h * 100)
extern unsigned long t_old;         // Previous GPS timestamp (milliseconds)
extern unsigned long t_new;         // Current GPS timestamp (milliseconds)
extern unsigned long v_100;         // Speed value * 100 for integer math precision
extern float v;                     // Current speed in km/h (floating point)
extern bool usingInterrupt;         // Flag indicating if GPS uses interrupt-based reading
extern int lagGPS;                  // Time delay since last GPS update (milliseconds)
extern int v_g;                     // GPS speed (alternate variable)
extern float odo;                   // Total odometer reading in kilometers (saved to EEPROM)
extern float odoTrip;               // Trip odometer in kilometers (resettable, saved to EEPROM)
extern float distLast;              // Distance traveled since last GPS update (km)
extern byte hour;                   // Current GPS hour (UTC, 0-23)
extern byte minute;                 // Current GPS minute (0-59)

// ===== STEPPER MOTOR POSITION VARIABLES =====
extern unsigned int spd_g;          // Speedometer target value (mph * 100)
extern unsigned int fuelLevelPct_g; // Fuel level percentage * 10
extern unsigned int coolantTemp_g;  // Coolant temperature for gauge calculation

// ===== ROTARY ENCODER VARIABLES =====
extern bool button;                 // Button press event flag (set when press completes)
extern volatile bool encoderMoved;  // Flag set when encoder rotates (for immediate display update)

// ===== TIMING VARIABLES =====
extern unsigned long timer0, timerDispUpdate, timerCANsend;
extern unsigned long timerSensorRead, timerTachUpdate, timerTachFlash;
extern unsigned long timerCheckGPS, timerGPSupdate, timerAngleUpdate;
extern unsigned long timerHallUpdate;
extern unsigned long timerEngineRPMUpdate;
extern unsigned long timerSigSelectUpdate;

// ===== CAN BUS ENGINE PARAMETERS =====
extern int rpmCAN;                  // Engine RPM (direct value, 0-10000+)
extern int mapCAN;                  // Manifold Absolute Pressure in kPa * 10
extern int tpsCAN;                  // Throttle Position Sensor percentage * 10
extern int fuelPrsCAN;              // Fuel pressure in kPa * 10 (absolute pressure)
extern int oilPrsCAN;               // Oil pressure in kPa * 10 (absolute pressure)
extern int injDutyCAN;              // Injector duty cycle percentage * 10
extern int ignAngCAN;               // Ignition timing in degrees BTDC * 10
extern int afr1CAN;                 // Air/Fuel Ratio * 1000
extern int knockCAN;                // Knock sensor level
extern int coolantTempCAN;          // Coolant temperature in Kelvin * 10
extern int airTempCAN;              // Intake Air Temperature in Kelvin * 10
extern int fuelTempCAN;             // Fuel temperature in Kelvin * 10
extern int oilTempCAN;              // Oil temperature in Celsius * 10
extern int transTempCAN;            // Haltech transmission temperature in Kelvin * 10
extern int fuelCompCAN;             // Fuel composition (ethanol %) * 10
extern int fuelLvlCAN;              // Fuel level percentage (0-100)
extern int baroCAN;                 // Barometric pressure in kPa * 10
extern int spdCAN;                  // Vehicle speed sent to CAN bus (km/h * 16)
extern int pumpPressureCAN;         // Fuel pump pressure (test variable)

// ===== OBDII POLLING VARIABLES =====
extern unsigned long timerOBDIIPriority1;  // Timer for 10Hz priority 1 polls
extern unsigned long timerOBDIIPriority2;  // Timer for 1Hz priority 2 polls
extern bool obdiiAwaitingResponse;         // Flag indicating waiting for OBDII response
extern uint8_t obdiiCurrentPID;            // Current PID being polled

// ===== PROCESSED ENGINE PARAMETERS FOR DISPLAY =====
extern float oilPrs;                // Oil pressure in kPa (gauge pressure)
extern float coolantTemp;           // Coolant temperature in Celsius
extern float fuelPrs;               // Fuel pressure in kPa (gauge pressure)
extern float oilTemp;               // Oil temperature in Celsius
extern float fuelLvl;               // Fuel level in percent of capacity (0-100)
extern float battVolt;              // Battery voltage in volts
extern float afr;                   // Air/Fuel Ratio
extern float fuelComp;              // Ethanol percentage (0-100%)
extern float manifoldPrs;           // Manifold Absolute Pressure in kPa
extern float boostPrs;              // Boost pressure display (actually MAP for ease of use)
extern int RPM;                     // Engine RPM for display
extern int spd;                     // Vehicle speed in km/h * 100
extern float spdMph;                // Vehicle speed in miles per hour

// ===== SERIAL SIGNAL SOURCE VARIABLES =====
// Values set via serial commands when SPEED_SOURCE=6 or RPM_SOURCE=4
extern int spdSerial;               // Speed set via serial (km/h * 100), used when SPEED_SOURCE == 6
extern int rpmSerial;               // RPM set via serial, used when RPM_SOURCE == 4
extern float oilPrsSerial;          // Oil pressure (kPa gauge) set via serial, used when OIL_PRS_SOURCE == 6
extern float coolantTempSerial;     // Coolant temperature (Celsius) set via serial, used when COOLANT_TEMP_SOURCE == 4
extern float fuelLvlSerial;         // Fuel level (% of capacity) set via serial, used when FUEL_LVL_SOURCE == 3

// ===== CAN BUS COMMUNICATION BUFFERS =====
extern byte canMessageData[8];      // Received CAN message data
extern unsigned long rxId;          // Received CAN message ID
extern unsigned char len;           // Length of received CAN message
extern unsigned char rxBuf[8];      // Raw receive buffer from CAN controller

// ===== LOOKUP TABLES =====
extern const int thermTable_length;
extern uint16_t thermTable_x[];   // Voltage breakpoints in millivolts
extern int16_t  thermTable_l[];   // Temperature values in Celsius
extern const int fuelLvlTable_length;
extern const uint16_t fuelLvlTable_x[]; // Voltage breakpoints in millivolts
extern const uint8_t  fuelLvlTable_l[]; // Gallons * 10 remaining

// ===== EEPROM STORAGE ADDRESSES =====
extern byte dispArray1Address;      // Display 1 menu selections (4 bytes)
extern byte dispArray2Address;      // Display 2 selection (1 byte)
extern byte clockOffsetAddress;     // Time zone offset for clock (1 byte)
extern byte odoAddress;             // Total odometer value (4 bytes)
extern byte odoTripAddress;         // Trip odometer value (4 bytes)
extern byte fuelSensorRawAddress;   // Last fuel sensor reading (4 bytes)
extern byte unitsAddress;           // Unit system selection (1 byte)
extern uint16_t splashValidFlag1Address; // Splash slot 1 validity flag address
extern uint16_t splashValidFlag2Address; // Splash slot 2 validity flag address
extern uint16_t customSplash1Address;    // Custom splash image slot 1 start address
extern uint16_t customSplash2Address;    // Custom splash image slot 2 start address

// ===== MENU NAVIGATION VARIABLES =====
extern byte menuLevel;              // Current menu depth
extern byte units;                  // Unit system: 0=metric, 1=imperial
extern unsigned int nMenuLevel;     // Number of items in current menu level
extern byte dispArray1[4];          // Menu position array for display 1
extern byte dispArray2[1];          // Screen ID shown on display 2 (1-17, same IDs as display 1)

// ===== USER-SELECTED SCREEN LISTS =====
#define MAX_SCREEN_LIST 17          // Screen IDs 1-17 (Settings, ID 0, and retired IDs 13/14 are not listable)
extern byte disp1List[MAX_SCREEN_LIST]; // Ordered screen IDs scrolled through on display 1
extern byte disp1Count;                 // Number of valid entries in disp1List
extern byte disp2List[MAX_SCREEN_LIST]; // Ordered screen IDs selectable for display 2
extern byte disp2Count;                 // Number of valid entries in disp2List
extern uint16_t disp1ListAddress;       // EEPROM: count byte followed by MAX_SCREEN_LIST IDs
extern uint16_t disp2ListAddress;

// ===== DISPLAY OPTIMIZATION VARIABLES =====
// Previous values for dirty tracking
extern float oilPrs_prev;           // Previous oil pressure for dirty tracking
extern float coolantTemp_prev;      // Previous coolant temp for dirty tracking
extern float oilTemp_prev;          // Previous oil temp for dirty tracking
extern float fuelPrs_prev;          // Previous fuel pressure for dirty tracking
extern float fuelLvl_prev;          // Previous fuel level for dirty tracking
extern float vBatt_prev;            // Previous battery voltage for dirty tracking
extern float afr_prev;              // Previous AFR for dirty tracking
extern float fuelComp_prev;         // Previous fuel composition for dirty tracking
extern float boostPrs_prev;         // Previous boost pressure for dirty tracking
extern int RPM_prev;                // Previous RPM for dirty tracking
extern int spd_prev;                // Previous speed for dirty tracking
extern byte hour_prev;              // Previous hour for clock dirty tracking
extern byte minute_prev;            // Previous minute for clock dirty tracking
extern byte dispArray1_prev[4];     // Previous display 1 menu state
extern byte dispArray2_prev;        // Previous display 2 selection
extern bool staticContentDrawn1;    // Flag: static content drawn on display1
extern bool staticContentDrawn2;    // Flag: static content drawn on display2

// Variable refresh rate timers
extern unsigned long timerDisp1Update;  // Timer for display 1 updates
extern unsigned long timerDisp2Update;  // Timer for display 2 updates

// ===== FAULT FLASH STATE =====
extern unsigned long timerFaultFlash;   // Timer for fault display flash toggle
extern bool faultFlashState;            // Current inversion state for fault flash (true = inverted)

// ===== FAULT DEBOUNCE STATE =====
extern unsigned long timerOilFaultDebounce;
extern unsigned long timerCoolantFaultDebounce;
extern unsigned long timerBattFaultDebounce;
extern unsigned long timerFuelFaultDebounce;
extern bool oilFaultActive;      // Debounced oil pressure fault
extern bool coolantFaultActive;  // Debounced coolant temperature fault
extern bool battFaultActive;     // Debounced battery voltage fault
extern bool fuelFaultActive;     // Debounced low fuel fault

#endif // GLOBALS_H
