125jdavis/gauge/gauge_V4/display.h

/*
 * ========================================
 * DISPLAY FUNCTIONS
 * ========================================
 * 
 * OLED display rendering functions
 * These functions render specific screens and data on the OLED displays
 */

#ifndef DISPLAY_H
#define DISPLAY_H

#include <Arduino.h>
#include <Adafruit_SSD1306.h>

// Main display control functions
void disp2(void);                                    // Display 2 main controller
void dispMenu();                                      // Display 1 menu system controller

// Menu header screens
void dispSettings(Adafruit_SSD1306 *display);       // "SETTINGS" header
void dispDisp2Select(Adafruit_SSD1306 *display);    // "DISPLAY 2" header
void dispUnits(Adafruit_SSD1306 *display);          // "UNITS" header
void dispClockOffset(Adafruit_SSD1306 *display);    // "SET CLOCK" header

// Data display screens
void dispRPM(Adafruit_SSD1306 *display);            // RPM numerical display
void dispSpd(Adafruit_SSD1306 *display);            // Speed numerical display
void dispOilTemp(Adafruit_SSD1306 *display);        // Oil temperature
void dispFuelPrs(Adafruit_SSD1306 *display);        // Fuel pressure
void dispFuelComp(Adafruit_SSD1306 *display);       // Fuel composition (ethanol %)
void dispAFR(Adafruit_SSD1306 *display);            // Air/Fuel Ratio
void dispIgnAng(Adafruit_SSD1306 *display);         // Ignition angle
void dispInjDuty(Adafruit_SSD1306 *display);        // Injector duty cycle
void dispBoostPSI(Adafruit_SSD1306 *display);        // Boost pressure bar gauge (PSI, imperial)
void dispBoostKPA(Adafruit_SSD1306 *display);        // Boost pressure bar gauge (kPa, metric)
void dispBoostGfx(Adafruit_SSD1306 *display);        // Boost pressure with turbo icon and bar gauge
void dispBoost(Adafruit_SSD1306 *display);           // Boost pressure with turbo icon (text only, no bar)
void dispClock(Adafruit_SSD1306 *display);          // Clock display
void dispTripOdo(Adafruit_SSD1306 *display);        // Trip odometer

// Graphical display screens (with icons)
void dispOilPrsGfx(Adafruit_SSD1306 *display);      // Oil pressure with icon
void dispOilTempGfx(Adafruit_SSD1306 *display);     // Oil temp with icon
void dispCoolantTempGfx(Adafruit_SSD1306 *display); // Coolant temp with icon
void dispBattVoltGfx(Adafruit_SSD1306 *display);    // Battery voltage with icon
void dispFuelLvlGfx(Adafruit_SSD1306 *display);     // Fuel level with icon

// Logo/image displays
void dispFalconScript(Adafruit_SSD1306 *display);   // Falcon logo
void disp302CID(Adafruit_SSD1306 *display);         // 302 CID logo
void disp302V(Adafruit_SSD1306 *display);           // 302V logo
void disp2300turbo(Adafruit_SSD1306 *display);      // 2300 Turbo Logo

// Odometer reset confirmation screens
void dispOdoResetYes(Adafruit_SSD1306 *display);    // "YES" confirmation
void dispOdoResetNo(Adafruit_SSD1306 *display);     // "NO" confirmation

// Utility functions
byte digits(float val);                              // Count digits in number for centering

// Display optimization functions
bool needsUpdate_Temperature(float current, float previous);  // Redraw when displayed integer (0dp, unit-converted) changes
bool needsUpdate_Pressure(float current, float previous, byte units);  // Redraw when displayed value (1dp bar / 0dp PSI) changes
bool needsUpdate_Speed(int current, int previous);   // Redraw when displayed integer (0dp, unit-converted) changes
bool needsUpdate_RPM(int current, int previous);     // Redraw when integer RPM changes
bool needsUpdate_Boost(float current, float previous, byte units);  // Redraw when displayed value (int kPa / 1dp PSI) changes
bool needsUpdate_Time(byte hour_curr, byte minute_curr, byte hour_prev, byte minute_prev);  // Check if time changed
bool needsUpdate_ModeChange(byte* current, byte* previous, int size);  // Check if display mode changed
unsigned int getDisplayUpdateInterval(byte displayMode, byte displayNum);  // Get refresh rate for display mode (displayNum: 1 or 2)

#endif // DISPLAY_H
