125jdavis/gauge/(commit log)

2024-08-20 Update gauge_V4.ino
    functional gauge motors
2024-08-25 folder made to work in arduino IDE
2025-11-09 Add comprehensive comments: header, libraries, defines, globals, setup, loop, sensors, navigation
2025-11-09 Add comments for display functions, CAN bus, clock, and utility functions
2025-11-09 Complete comprehensive commenting: GPS, motors, LED tach, shutdown, and utility functions
2025-11-10 Fix rotary encoder switch bugs - add pinMode and fix comparison operator
    [gauge_V4.ino]
2025-11-10 Delete gauge_V4/MotorControl.cpp
    not needed
2025-11-10 Fix encoder button debounce by updating state only on valid transitions
    [gauge_V4.ino]
2025-11-10 Fix encoder button by using static local variables in swRead()
    [gauge_V4.ino]
2025-11-10 Fix SWITCH pin definition - V4 hardware uses pin 1, not pin 24
    [gauge_V4.ino]
2025-11-10 add hall speed sensor functionality
2025-11-12 Schematic of hardware for this project
    V4 of gauge control unit
2025-11-17 Refactor sensor variable definitions with annotations
    Updated sensor variable definitions to include configuration and hardware parameter annotations for clarity.
2025-11-18 Fix EEPROM bug, refactor hardware pins to constexpr, and add STYLE.md
    [gauge_V4.ino]
2025-11-18 Fix remaining comment reference to old constant name
    [gauge_V4.ino]
2025-11-19 Convert calibration parameters to regular variables and harmonize filter naming
2025-11-19 Fix array bound compilation error by making LED constants constexpr
    [gauge_V4.ino]
2025-11-19 Fix array bound error with MAX_LEDS constant while keeping NUM_LEDS calibratable
    [gauge_V4.ino]
2025-11-19 Add LED zone validation to prevent runtime configuration errors
    [gauge_V4.ino]
2025-11-19 Create initial configuration and sensor modules
2025-11-20 Fix compilation errors: remove duplicate definitions from globals.cpp
    [globals.cpp]
2025-11-20 Fix missing function declarations and includes
    [display.cpp, menu.cpp, menu.h, utilities.cpp]
2025-11-20 Fix syntax error and Arduino IDE multiple .ino compilation issue
    [display.cpp]
2025-11-20 Fix multiple definition errors by using extern declarations
    [config_calibration.cpp, config_calibration.h]
2025-11-20 Fix duplicate goToLevel0 and missing comment closure
    [display.cpp]
2025-11-20 Add Hall sensor odometer integration with speed source selection
2025-11-20 Unify speed source selection in sigSelect with switch statement
2025-11-20 Revert to integer speed format (km/h * 100) for efficiency
    [sensors.cpp]
2025-11-20 Convert filter alphas to uint8_t and use integer math for RPM
2025-11-20 Rename PULSES_PER_REVOLUTION to CYL_COUNT and refactor filter names
2025-11-21 Fix compilation error: rename 'map' to 'manifoldPrs' to avoid Arduino function conflict
    [globals.cpp, globals.h, sensors.cpp]
2025-12-28 Fix: Change spdHall from int to unsigned int to prevent negative speed values
    [globals.cpp, globals.h]
2025-12-28 Fix: Cast EMA filter calculation to unsigned long to prevent overflow
    [sensors.cpp]
2025-12-28 Fix: Add max pulse interval check and speed decay to prevent spikes and hanging
    [sensors.cpp]
2025-12-28 Refactor: Replace magic numbers with named constants for better maintainability
    [config_hardware.h, sensors.cpp]
2025-12-28 Fix: Skip first 2 pulses after standstill to prevent initial speed spike
    [sensors.cpp]
2025-12-28 Refactor: Replace magic numbers with named constant for pulse skip count
    [config_hardware.h, sensors.cpp]
2025-12-28 Fix: Correct pulse skip logic to use < instead of <= for exact count
    [sensors.cpp]
2025-12-28 Implement VR-safe combined filter with median, state machine, and acceleration limiting
2025-12-28 Fix: Address code review issues - add constants, fix underflow, use 64-bit math
    [sensors.cpp]
2025-12-28 Fix: Prevent sawtooth pattern by only calculating speed from fresh pulse data
    [sensors.cpp]
2026-01-12 Update odometer calibration parameters
2026-01-14 Implement mechanical odometer motor control with distance-proportional stepping
2026-01-14 Fix ODO_STEPS data type from uint8_t to uint16_t to handle 4096 steps
    [config_calibration.cpp, config_calibration.h]
2026-01-14 Simplify motor calculation and use Arduino-compatible rounding (no round() function needed)
2026-01-14 Implement non-blocking odometer motor control with incremental stepping
2026-01-14 Fix fractional step rounding in non-blocking odometer motor update
    [outputs.cpp]
2026-01-14 Improve odometer motor type safety and handle first-run initialization
2026-01-17 Add motorS for speedometer with integer math (DIR=47, STEP=45, 118° sweep, 16 microsteps)
2026-01-17 Fix calculation comment, add overflow protection, and clarify mapping logic
    [config_calibration.cpp, outputs.cpp]
2026-01-18 Implement timer-based motor updates (10kHz) and audit all ISRs for performance
2026-01-18 Fix CPU overhead calculations (10-20% not 1-2%)
    [config_hardware.h, gauge_V4.ino]
2026-01-18 Make motor sweep timing configurable (default 200ms per direction)
2026-01-18 Fix overflow handling and use named constant for min delay
    [outputs.cpp]
2026-01-18 Fix edge cases: handle zero sweep time and dynamically find max sweep
    [outputs.cpp]
2026-01-18 Add yield() calls to prevent watchdog timeouts during sweep
    [outputs.cpp]
2026-01-19 Add synthetic signal generators for coolant temp, oil/fuel/manifold pressure, fuel level, and RPM
2026-01-19 Fix generateRPM to return value instead of setting global
    [sensors.cpp, utilities.cpp]
2026-01-20 Update ODO_PINs for odometer motor hardware
    previously set to wrong pins
    [config_hardware.h]
2026-01-20 Add yield() to main loop to prevent excessive spinning and fix COOLANT_TEMP_SOURCE config
    [config_calibration.cpp, gauge_V4.ino]
2026-01-20 Add delayMicroseconds(100) to prevent wasteful 10,000 Hz loop spinning at startup
    [gauge_V4.ino]
2026-01-20 Fix loop rate throttling: use delay(20) for consistent ~50Hz matching smooth display update performance
    [gauge_V4.ino]
2026-01-20 Fix 64-second loop rate transition: change timer variables from unsigned int to unsigned long
    [globals.cpp, globals.h, menu.cpp]
2026-01-20 Separate sigSelect to 100Hz timer and make generateRPM() time-based
2026-01-20 Change sensor read rate from 10ms to 20ms
2026-01-20 Replace Arduino Stepper library with non-blocking direct pin control for odometer motor
    [gauge_V4.ino, globals.cpp, globals.h, outputs.cpp]
2026-01-20 Add documentation for odometer motor fix
2026-01-20 Clarify motor reversal documentation
2026-01-21 Update odoMotorStepIndex increment for reverse stepping
    Change motor step index increment from 1 to 3 for reverse direction.
    [outputs.cpp]
2026-01-21 Reduce OLED update rate from 10Hz to 8.3Hz for smoother motor motion
2026-01-21 Fix comment precision: 8.3Hz -> 8.33Hz
    [config_hardware.h]
2026-01-21 Reorder main loop: motor angle updates before display to eliminate jitter
    [config_hardware.h, gauge_V4.ino]
2026-01-21 Fix variable scope issues in OBDII parsing and add protocol documentation
    [can.cpp]
2026-01-21 Fix bugs: Big Endian byte packing, temperature conversion, and lambda scaling
    [can.cpp]
2026-01-21 Fix CAN speed storage for AiM and OBDII protocols
    [can.cpp]
2026-01-22 Add wheel speed averaging for Haltech and VSS1 for Megasquirt
2026-01-22 Add MCP2515 hardware CAN message filtering to reduce MCU load
2026-01-22 Add comprehensive hardware filtering documentation
2026-01-25 Implement position interpolation for motorS smoothing
2026-01-25 Fix code review issues: overflow handling and global variable modification
    [outputs.cpp]
2026-01-25 Fix initialization to avoid needle jump on first call
    [outputs.cpp]
2026-01-25 Improve millis() overflow handling to maintain smooth motion continuity
2026-01-25 Add comprehensive documentation for motor smoothing implementation
2026-02-07 Cap motor smoothing interval to 500ms instead of 10 seconds
2026-02-07 Fix code review issues: add fuelComp_prev, remove unreachable code, fix duplicate case
    [display.cpp, globals.cpp, globals.h]
2026-02-07 Fix duplicate case handling and prevent global variable modification in display code
    [display.cpp]
2026-02-07 Add display parameter to getDisplayUpdateInterval to correctly handle overlapping case numbers
    [display.cpp, display.h, gauge_V4.ino]
2026-02-13 Configure SPI clock to 8MHz for OLED displays
2026-02-15 Improve comment accuracy for menu indices and pressure tick marks
2026-02-15 Correct boost gauge: range, ticks, refresh rate, decimals, and thresholds
    [display.cpp]
2026-02-15 Fix mapFloat compilation error by including utilities.h
    [display.cpp]
2026-02-15 Fix Adafruit_SSD1306 begin() call - remove unsupported 5th parameter
    [gauge_V4.ino]
2026-02-15 Fix EEPROM.write parameters swapped in clock offset save
    [display.cpp]
2026-02-16 Fix clock offset display and menu navigation responsiveness
    [display.cpp, gauge_V4.ino, globals.cpp, globals.h, menu.cpp]
2026-02-16 Fix Display 2 delay when entering menu level 2 with button press
    [gauge_V4.ino]
2026-02-16 Fix clock offset adjustment not displaying actual clock time
    [display.cpp]
2026-02-16 Fix clock offset adjustment - add dirty tracking and fix interrupt handling
    [config_calibration.cpp, config_calibration.h, display.cpp]
2026-02-17 Fix unit and display selection delays - force immediate updates on entry
    [display.cpp]
2026-02-17 Revert Display 1 feedback and investigate encoder delay issue
    [display.cpp]
2026-02-17 Fix 30-second encoder delay by validating menu indices on entry
    [display.cpp]
2026-02-17 Fix kPa boost gauge to use 101 kPa as zero point (atmospheric pressure)
    [display.cpp]
2026-02-17 Fix dispBoostGfx and dispBoost per user feedback
    [display.cpp]
2026-02-17 Fix dispBoost text size, slow boost simulation, center settings text
    [display.cpp, utilities.cpp]
2026-02-17 Fix dispBoost text overflow - reposition units to fit within display
    [display.cpp]
2026-02-18 Fix nMenuLevel initialization and force display update after odo reset
    [display.cpp, globals.cpp]
2026-02-18 Fix dispOdoResetNo display update by deferring force update flag
    [display.cpp]
2026-02-21 Add adaptive position interpolation (smoothing) to motors 1-4
2026-02-21 Fix trip odometer stale display and stuck screen on scroll
    [display.cpp, gauge_V4.ino]
2026-02-21 Fix trip odometer real-time updates and stuck screen on scroll
    [display.cpp, globals.cpp, globals.h]
2026-02-21 Fix shutdown: show screens reliably, clear LEDs, blank displays before power-off
    [utilities.cpp]
2026-02-21 Synchronize motor sweep timing — per-motor delays so all needles move together
2026-02-21 Fix mechanical odometer 2x error: ODO_STEPS 4096->2048 for wave-drive mode
    [config_calibration.cpp, outputs.cpp]
2026-02-22 Fix infinite shutdown loop by guarding power latch in setup()
    [gauge_V4.ino]
2026-02-22 Fix infinite shutdown loop: spin after releasing power latch in shutdown()
    [utilities.cpp]
2026-02-22 Remove setup() voltage check that prevented restart after shutdown
    [gauge_V4.ino]
2026-02-23 Fix shutdown: deenergize ULN2003 and motor driver before releasing power latch
    [utilities.cpp]
2026-02-24 Add fault flash: invert OLED display every 500ms when oil pressure, coolant temp, or battery voltage fault is detected
    [config_calibration.cpp, config_calibration.h, config_hardware.h, gauge_V4.ino, globals.cpp, globals.h]
2026-02-24 Add fault indicator LED: flash leds[0] orange/blue/green when oil pressure, coolant temp, or battery fault is active
2026-02-24 Fix LED tachometer for even and odd LED counts using pair-based algorithm
    [outputs.cpp]
2026-02-24 Fix battery voltage display refresh rate below specified 2Hz
    [display.cpp]
2026-02-24 Add 3s fault debounce and low fuel warning (purple LED)
2026-02-26 Remove I2C mention from communication protocols
2026-02-28 Add NEMA14 motorS custom zeroing: partial sweep factor and fixed step rate bypassing SwitecX12 accel table
    [config_calibration.cpp, config_calibration.h, outputs.cpp]
2026-03-04 Fix coil-negative tachometer RPM: volatile + int32_t EMA intermediates
    [globals.cpp, globals.h, sensors.cpp]
2026-03-06 Add calibratable debounce to ignitionPulseISR to suppress coil-ringdown RPM spikes
2026-03-06 Add RPM spike plausibility filter in ignitionPulseISR
2026-03-08 Update MS_SWEEP value for Motor S calibration
2026-03-09 Fix review comments: cleaner cast, corrected comments in synthetic generators
    [sensors.cpp, utilities.cpp]
2026-03-10 Fix RPM label positioning to match speed display pattern
    [display.cpp]
2026-03-10 Highlight limited SRAM on Arduino Mega
    Add note about limited dynamic memory on Arduino Mega.
2026-03-10 Document custom splash screen feature in specification
    Add custom splash screen configuration details, including EEPROM memory map, splash screen enumeration, Arduino implementation, serial protocol commands, and Python image conversion tool.
2026-05-25 feat: add speedometer backlight to LED tachometer strip
    Add SPEEDO_BACKLIGHT_ENABLED config parameter that, when enabled,
    lights all inactive tachometer LEDs with warm white (~3500K) at 25%
    brightness (CRGB 64,49,34) to provide backlight to the speedometer.
    - config_calibration.h/.cpp: declare and define SPEEDO_BACKLIGHT_ENABLED (default: 1/enabled)
    - outputs.cpp (ledShiftLight): replace hardcoded CRGB::Black with
    backlightColor derived from the config flag, applied to all
    LEDs that would otherwise be off (below TACH_MIN, blacked-out
    pairs during tach display, shift-zone flash-off, fault flash-off)
    Agent-Logs-Url: https://github.com/125jdavis/gauge/sessions/1d0b2e78-a5ec-47d4-a9cb-93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
    [config_calibration.cpp, config_calibration.h, outputs.cpp]
2026-05-25 fix LED color
2026-09-25 config tool updates
    [Grace_Config.txt]
2026-11-11 more good stuff
    sped up needle sweep, fixed oil temp read-in on CAN bus
2026-11-11 Add configurable analog pressure sensors
    Add calibrated 3 bar MAP and 100 PSIG readers, route analog inputs by configured sources, and update thermistor voltage breakpoints. Clamp pressure ADC input to the calibrated range and retain the prior MAP value when an analog input is shared with a pressure source.
2026-11-12 fuel and thermistor config tools
